BYU-Racing/bms_hardware/README.md

# BYU Racing 2027 BMS Project

This repo contains all relevant PCB files and explanations relating to the team's custom solution for a Battery Management System (BMS)

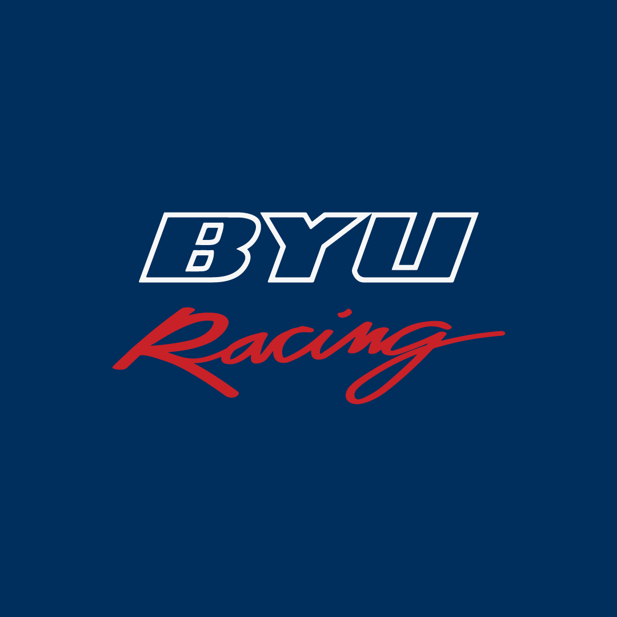
[picture p1: BYU_Racing_Logos/byulogo.png]
BMS board
