BYU-Racing/bms_hardware/Explanation_Documentation/README.md

# All main documentation relating to the 2027 BMS project

This is where you will see explanations of our BMS architecture. 
When individuals in leadership have questions about the BMS project this is where you point them. 

*We know they will never look here, but its still good to have these documents* 
***
If you are in the top leadership in the club and you are viewing this, congrats. Add to the counter \
**Leadership Viewer Count:** 0
