BYU-Racing/bms_hardware/cell_monitor_V2/README.md

# BMS Cell Monitor V2 Files
This folder contains the KiCad project files for the BMS Cell Monitor V2.

PCB handoff from Rugby 11/10/2026 ☠️🌹⛓️
