BYU-Racing/bms_hardware/Control_Unit_V2/README.md

# BMS Control Unit V2 Files
This folder contains the KiCad project files for the BMS Control Unit V2.

PCB handoff from Rugby 11/10/2026 ☠️🌹⛓️
