BYU-Racing/bms_hardware/bms_master_pcb2/README.md

## BMS Control Unit V1.01 KiCad Files

These PCB files are for the first version for the BMS Control Unit V1.01 (previously known as the BMS Master V1.01)
