BYU-Racing/bms_hardware/bms_icd.md

An *Interface Control Document* is a critical tool for systems that interact with users and/or other systems.

A description should be given of every interface of your system. You should discuss voltages and current rating, high voltage isolation, circuit protection, connectors (type of connector, physical location, pinout), communication protocols (baud rate, data types, etc.) and anything else necessary for someone to understand how your system interacts with nearby systems. You should not provide a detailed explanation of how your system works (that should go in a separate doc in your system folder).

# 1. BMS Master
## 1.1. CAN
##### CAN Protocol
The BMS has two CAN interfaces, or two independent CAN busses (named CAN A and CAN B)
1. **High Priority CAN (CAN A):** This will be for communication with the inverter.
2. **Low Priority CAN (CAN B):** This will be for sending data to be used by telemetry.

| Baud rate | CAN ID offset | CAN Message ID format |
| --- | --- | --- |
| 250Kbps | 0x12C | Standard (11-bit identifiers) |

Each of these default parameters can be configured as necessary, for example, the BMS will send an extended CAN ID frame for communication to the ELCON charger.
##### CAN Format
All messages have a length of 8 bytes and are in little-endian format, thus messages with less than 8 bytes of information will still have a length of 8 bytes. 

Each data frame is 108 bits (or 126 bits with an extended ID), and so at 250Kbps the bus can handle a maximum of 1984 to 2314 messages per second.
##### CAN Data Formats
Message data is formatted and scaled as follows:
| Data | Description | Type | Range | Factor 
| ---- | --- | ---- | ----- | --- |
| Boolean | 1=true/on; 0=false/off | unsigned byte | 0 or 1 | 0 |
| Cell Voltage | Voltage (in mV) times 10 | unsigned 16-bit integer | 0 to 6553.5 mV | 0.1 |
| Low Voltage | Voltage (in V) times 100 | signed 16-bit integer | -327.68 to 327.67 V | 0.01
| High Voltage | Voltage (in V) times 10 | signed 16-bit integer | -3276.8 to 3276.7 V | 0.1
| Temperature | Temperature in °C times 10 | signed 16-bit integer | -3276.8 to 3276.7 °C | 0.1

##### CAN Database File
*a link will be placed here to access a .dbc file of the CAN network*
## 1.2. Digital Outputs
The BMS Master will have a digital output pin that pulls high for normal and to ground for fault. The digital output will be sent out of the TB through the TB Carrier Board or directly through the TB Bulkhead Connector
## 1.3. isoSPI
The BMS master will communicate with the BMS Slaves through a series isoSPI connection. The LTC6811-1 BMS Slave ICs are already configured for this. An LTC6820 isoSPI transciever will be used to protect the BMS Master from the HV Section of the TB Carrier Board. The isoSPI connector will be a MOLEX micro fit jr. 
## 1.4. Energy Meter Passthrough
The BMS Master board will pass a connection from the BMS Slaves to the TB Carrier Board. This will have no circuitry nearby in order to prove that the energy meter signal is clean. HV spacing will be used (if required). The energy meter wires will connect through the same MOLEX micro fit jr.
*Wait for rules to come out to make a decision, as Energy Meter rules are changing.*

## 1.5. Happy Lights
The BMS Master will have labelled indicator lights that represent each BMS state, the value of the digital output(s), and other indicator lights as deemed necessary.
## 1.6. Power (GLV)
The BMS will receive and tolerate fused 12V-15V power input. The BMS is expected to draw less than 500mA max. 
## 1.7. Connection to TB Carrier Board
The BMS Master may connect to a larger carrier board in the Tractive Battery, using breadboard headers. 
## 1.8. USB Data Lines
## 1.9. Charging
**To-Do:**
- communication with charger over CAN. 
- pull digital signal during fault for shutdown circuit.
- test Elconn charger with Ben.

# 2. BMS Slave
## 2.1. isoSPI
LTC6811-1 works with isoSPI natively.
## 2.2. Power (Buck Converter)
Each module will power a 5V Buck for the Slave IC and other onboard ICs.
## 2.3. Flex PCB Connector
Molex 2254330120 Female Connector lives on Slave PCB. 
## 2.4. Happy Lights
- Buck Powering 5V VREG rail
## 2.5. Energy Meter Passthrough
Teams are required to have at least one Energy Meter temperature sensor per Module in the Tractive 
Battery Pack. The sensors used must be an Analog Devices DS18B20 (any package) wired for parasite power Vdd 
connected to Gnd.  Multiple sensors should be connected in parallel. The sensors must also have appropriate levels of electrical isolation between the sensor and cell.
## 2.6. Fusing
Littelfuse 01550900M Cartridge will hold 250mA fuses for the voltage taps and 500mA fuses for V+ and GND_REF.

# 3. Flex PCB
## 3.1. Connection with Slave Boards
FPC inserts into the Molex 2190190120 Female Connector which then mates with the PCB mount Molex Connector. See BMS Slave 2.3
## 3.2. Connection to Voltage Taps
Currently testing soldered connection points.
## 3.3. Thermistors
Vishay NTCS0603E3103FLT thermistors with solder pads (0603) living on FPC.
## 3.5. Mounting & Mechanical Interface
TBD. some sort of thermal epoxy or Kapton tape might be necessary to prevent any shorts on FPC.

# 4. BMS Slave Testing
