BYU-Racing/bms_hardware/Explanation_Documentation/OG_2027_BMS_Timeline.md

## Master & Slave PCB timelines:

- September 22nd Design review for mostly finalized V1 PCBs

- September 28th V2 PCBs ordered (make sure it can work)
- October 13th V2 PCBs arrive
- October 31st V2 testing and bugs FIXED
- Nov 3rd Design review for mostly finalized V2 PCBs

- Nov 9th V3 PCBs ordered (needs to be finalized enough to use on flat car)
- Nov 24th PCB V3 arrives
- Dec 10th V3 PCB testing done and bugs fixed

- Dec 15th V4 PCB design ordered (competition ready and will work on car)
- Week of Jan 3rd V4 PCBs arrive
- Week of Jan 10th Install V4 on actual TB modules

*By end of V1 hardware mainly works \
*By end of V2 hardware fully works (with isoSPI) \
*V3 fully rules compliant and final connector interface (removing most testing stuff)

## FPC timeline:
- week of sept 13th check module fit and adjust accordingly
- week of September 20th V1 main mechanical stress tests
- week of 27th finalize V1 design
- October 5th order V2 FPCs
- October 20th V2 FPCs arrive
- October 27th V2 FPC mechanical fitting done and adjustments made accordingly
- Nov 5th more stress testing complete and adjustments made accordingly
- Nov 10th design review for mostly finalized V2
- Nov 16th FINAL FPC iteration ordered (bulk order of minimum 50 or so)
- Dec 3rd V3 (final) FPCs arrive
- Dec 10th all TB modules have FPCs mounted (Jan 9th at the latest)
