BYU-Racing/bms_hardware/BOMs/BYU_Racing_2027_Extra_Components.xlsx

Index | Manufacturer Part Number | Manufacturer Name | Description | Product Notes
1 | LM393 | Shenzhen Slkormicro Semicon Co., Ltd. | IC COMPARATOR 2CH 8-SOP
2 | 2N7002 | Shenzhen Slkormicro Semicon Co., Ltd. | 60V 115MA 7.5@10V,500MA 225MW N
3 | IRF540ZPBF | Infineon Technologies | MOSFET N-CH 100V 36A TO220AB
4 | AGQ20012 | Panasonic Industry | RELAY TELECOM DPDT 2A 12V
5 | SPAN02A-12 | MEAN WELL USA Inc. | DC DC CONVERTER 12V 2W
6 | BAT54C | SMC Diode Solutions | DIODE ARR SCHOTT 30V 100MA SOT23
7 | FOD817B300W | onsemi | OPTOISOLATOR 5KV 1CH TRANS 4-DIP
8 | J1021CS312VDC.20 | CIT Relay and Switch | RELAY GEN PURPOSE SPDT 3A 12V
9 | ESR03EZPF1002 | Rohm Semiconductor | RES 10K OHM 1% 1/4W 0603
10 | ESR03EZPF1003 | Rohm Semiconductor | RES 100K OHM 1% 1/4W 0603
11 | BSS84 | Shenzhen Slkormicro Semicon Co., Ltd. | 50V 130MA 10@5V,100MA 200MW 2.5V
12 | CC0603JRX7R7BB104 | YAGEO | CAP CER 0.1UF 16V X7R 0603
13 | 2165711005 | Molex | MICRO-FIT PLUS SR VT HDR ASSY TI
14 | 2157591005 | Molex | CONN RCPT HSG 5POS 3.00MM
15 | HVR2500001004FR500 | Vishay Beyschlag/Draloric/BC Components | RES 1M OHM 1/4W 1% AXIAL
16 | VR25000004704FA500 | Vishay Beyschlag/Draloric/BC Components | RES 4.7M OHM 1% 1/4W AXIAL
17 | 0885001.DR | Littelfuse Inc. | FUSE BOARD MOUNT 1A 500VDC 2SMD
18 | CD4043BDR | Texas Instruments | IC S-R LATCH 1:1 16-SOIC
19 | CD4071BM96 | Texas Instruments | IC OR 4-CIR 2-IN 14-SOIC
20 | 422B-340G | MG Chemicals | CONFORMAL COATING SILICONE 14OZ
21 | DKS-PCB-RULER-12INCH | DigiKey Standard | PCB LAYOUT REFERENCE RULER 12"
22 | 1445022-2 | TE Connectivity AMP Connectors | CONN RCPT HSG 2POS 3.00MM
23 | 1445022-8 | TE Connectivity AMP Connectors | CONN RCPT HSG 8POS 3.00MM
24 | SMM02070C2201FBP00 | Vishay | RES SMD 2.2K OHM 1% 1W MELF
25 | SHV12-1A85-78D4K | Standex-Meder Electronics | RELAY REED SPST 1A 12V
26 | MRE12-1A85-HC | Standex-Meder Electronics | HIGH VOLTAGE REED RELAY, FORM 1A
27 | 0430452414 | Molex | CONN HEADER VERT 24POS 3MM
28 | IXCY10M90S | IXYS | IC CURRENT REGULATOR TO252AA
29 | 1N4757A | Taiwan Semiconductor Corporation | DIODE ZENER 51V 1W DO204AL
30 | EV200AAANA | TE Connectivity Aerospace, Defense and Marine | RELAY CONTACTOR SPST 500A 12V
31 | TMR 3-2421WIR | Traco Power | DC DC CONVERTER +/-5V 3W
32 | MCP6002T-E/MS | Microchip Technology | IC OP AMP 2CH 8-MSOP
33 | 6572503103F | Dialight | LED PNL IND RED DIFF 16.50MM LDS
34 | 0436500815 | Molex | CONN HEADER VERT 8POS 3MM
35 | 0436500200 | Molex | CONN HEADER R/A 2POS 3MM
36 | A17733-04 | Laird Technologies - Thermal Materials | THERM PAD 228.6MMX228.6MM W/ADH
37 | A17747-04 | Laird Technologies - Thermal Materials | THERM PAD 228.6MMX228.6MM PURP
38 | KIT-ICD-A-300-CAN2-12 | Isabellenhuette USA | CURRENT SENSOR SHUNT 300A
39 | B57861S0103F040 | TDK | THERMISTOR NTC 10KOHM 3988K BEAD
