BYU-Racing/bms_hardware/BOMs/BYU Racing 2027 BMS Cell Monitor.xlsx

Index | Manufacturer Part Number | Manufacturer Name | Description | Product Notes
1 | DC2259A | Analog Devices Inc. | EVAL BOARD FOR LTC6811-1
2 | NTCS0603E3103FLT | Vishay Beyschlag/Draloric/BC Components | THERMISTOR NTC 10KOHM 3435K 0603
3 | LTC6811HG-1#3ZZTRPBF | Analog Devices Inc. | IC BATT MON MULTI 1-12C 48SSOP
4 | LTC1380IGN#TRPBF | Analog Devices Inc. | IC MUX 8:1 70OHM 16SSOP
5 | LT3990HMSE-5#PBF | Analog Devices Inc. | IC REG BUCK 5V 350MA 16MSOP
6 | BSS308PE | EVVO | MOSFET P-CH 30V 2A SOT23
7 | TG110-AE050N5LFTR | HALO Electronics, Inc. | ISO MOD 10/100 AEC X-TEMP
8 | 2190190120 | Molex | 1.5 FPC CONN 1ROW JACKET ASSY 12
9 | 2254330120 | Molex | 1.5 FPC CONN 1ROW REC ASSY RA 12
10 | 5002 | Keystone Electronics | PC TEST POINT MINIATURE WHITE
11 | 01550900M | Littelfuse Inc. | FUSE BLOK CARTRIDGE 125V 10A SMD
12 | 0451.500MRL | Littelfuse Inc. | FUSE BRD MT 500MA 125VAC/VDC SMD
13 | 0451.250MRL | Littelfuse Inc. | FUSE BRD MT 250MA 125VAC/VDC SMD
14 | LQH5BPH330MT0L | Murata Electronics | FIXED IND 33UH 750MA 516 MOHM
15 | AC1210KKX7R0BB225 | YAGEO | CAP CER 2.2UF 100V X7R 1210
16 | CRCW201033R0FKEFHP | Vishay Dale | RES SMD 33 OHM 1% 1W 2010
17 | ERJ-3EKF3743V | Panasonic Industry | RES SMD 374K OHM 1% 1/10W 0603
18 | M20-9771246 | Harwin Inc. | CONN HEADER VERT 12POS 2.54MM
19 | TMUX1308AQPWRQ1 | Texas Instruments | Automotive 5V, bidirectional 8:1
20 | TLV9002IDR | Texas Instruments | IC OP AMP 2CH 8-SOIC
21 | 0430300004 | Molex | CONN SOCKET 26-30AWG CRIMP TIN
22 | 0436500400 | Molex | CONN HEADER R/A 4POS 3MM
23 | 0436450400 | Molex | CONN RCPT HSG 4POS 3.00MM
24 | RMCA0603FT100R-HP | Stackpole Electronics Inc | RES 0603 100 OHM 1% 0.125W AUTO
25 | RMCA0603FT3K30-HP | Stackpole Electronics Inc | RES 0603 3.3 KOHM 1% 0.125W AUTO
26 | RMCA0805FT100R-HP | Stackpole Electronics Inc | RES 0805 100 OHM 1% 0.25W AUTO
27 | CRGH1206J470R | TE Connectivity Passive Product | RES 470 OHM 5% 1/2W 1206
28 | CRCW0603220KFKEA | Vishay Dale | RES SMD 220K OHM 1% 1/10W 0603
29 | RMCF0603FT2K20 | Stackpole Electronics Inc | RES 2.2K OHM 1% 1/10W 0603
30 | 560112116006 | Würth Elektronik | RES 4.7K OHM 1% 1/10W 0603
31 | CD74HC4067QDGSRQ1 | Texas Instruments | AUTOMOTIVE, 5V, 16:1, SINGLE CHA
32 | HM0068ANLT | Pulse Electronics | PULSE XFMR 1CT:1CT TX 1CT:1CT RX
