BYU-Racing/bms_hardware/BOMs/BYU Racing 2027 BMS Main Control Unit.xlsx

Index | Manufacturer Part Number | Manufacturer Name | Description | Product Notes
1 | STM32G474RET3 | STMicroelectronics | IC MCU 32BIT 512KB FLASH 64LQFP
2 | M20-9991046 | Harwin Inc. | CONN HEADER VERT 10POS 2.54MM
3 | TC2030-IDC | Tag-Connect LLC | PLUG-OF-NAILS 6-PIN W/ LEGS 8"
4 | SST26VF064B-104V/MF | Microchip Technology | IC FLASH 64MBIT SPI/QUAD 8WDFN
5 | LTC6820HMS#TRPBF | Analog Devices Inc. | IC INTERFACE SPECIALIZED 16MSOP
6 | TG110-AE050N5LFTR | HALO Electronics, Inc. | ISO MOD 10/100 AEC X-TEMP
7 | 0436500400 | Molex | CONN HEADER R/A 4POS 3MM
8 | 0436450400 | Molex | CONN RCPT HSG 4POS 3.00MM
9 | 0430300004 | Molex | CONN SOCKET 26-30AWG CRIMP TIN
10 | USBLC6-2SC6 | Shenzhen Slkormicro Semicon Co., Ltd. | 6A@8/20US 13V 78W@8/20US 9V 5V S
11 | 1N4448WS | Shenzhen Slkormicro Semicon Co., Ltd. | 75V INDEPENDENT TYPE 1.25V@150MA
12 | TCAN1044AVDDFRQ1 | Texas Instruments | IC TXRX TSOT-23-8
13 | AP2112K-3.3TRG1 | Diodes Incorporated | IC REG LINEAR 3.3V 600MA SOT-25
14 | TPL7407LADR | Texas Instruments | IC RLY/SOLENOID DRVR 16-SOIC
15 | USB4085-GF-A | GCT | CONN RCPT USB2.0 TYPE C 16+8POS
16 | GRT21BC71E475KE13L | Murata Electronics | CAP CER 4.7UF 25V X7S 0805
17 | GCM21BR71E105KA56L | Murata Electronics | CAP CER 1UF 25V X7R 0805
18 | C0603C270F3HACAUTO | KEMET | CAP CER 0603 27PF 25V ULTRA STAB
19 | TMK212BBJ106KGHT | Taiyo Yuden | CAP CER 10UF 25V X5R 0805
20 | GRT1555C1H241FA02D | Murata Electronics | CAP CER 240PF 50V C0G/NP0 0402
21 | GRT21BR61C226ME13K | Murata Electronics | CAP CER 22UF 16V X5R 0805
22 | 560112116006 | Würth Elektronik | RES 4.7K OHM 1% 1/10W 0603
23 | 560112116091 | Würth Elektronik | RES 2K OHM 1% 1/10W 0603
24 | RMCA0603FT120R-HP | Stackpole Electronics Inc | RES 0603 120 OHM 1% 0.125W AUTO
25 | RNCP0603FTD1K21 | Stackpole Electronics Inc | RES 1.21K OHM 1% 1/8W 0603
26 | RMCA0603ZT0R00-HP | Stackpole Electronics Inc | RES 0603 JUMPER AUTO 2.5A
27 | RMCA0603FT5K10-HP | Stackpole Electronics Inc | RES 0603 5.1 KOHM 1% 0.125W AUTO
28 | CRCW120660R0KNEAIF | Vishay Dale | RES SMD 60 OHM 10% 1/4W 1206 | No Backorders Allowed.
29 | RMCP0603FT1K00 | Stackpole Electronics Inc | RES 1K OHM 1% 1/4W 0603
30 | 74408063101 | Würth Elektronik | FIXED IND 100UH 500MA 850 MOHM
31 | LMR33620CQ5RNXRQ1 | Texas Instruments | IC REG BUCK 5V 2A 12VQFN
32 | CRCW06032K80FKEA | Vishay Dale | RES SMD 2.8K OHM 1% 1/10W 0603
33 | SST26VF064B-104I/SM | Microchip Technology | IC FLASH 64MBIT SPI/QUAD 8SOIJ
34 | HM0068ANLT | Pulse Electronics | PULSE XFMR 1CT:1CT TX 1CT:1CT RX
