BYU-Racing/bms_hardware/cell_monitor_V2/bms_cell_control_unit_V2.kicad_pcb

## KiCad design cell_monitor_V2/bms_cell_control_unit_V2.kicad_pcb (2026-11-14)

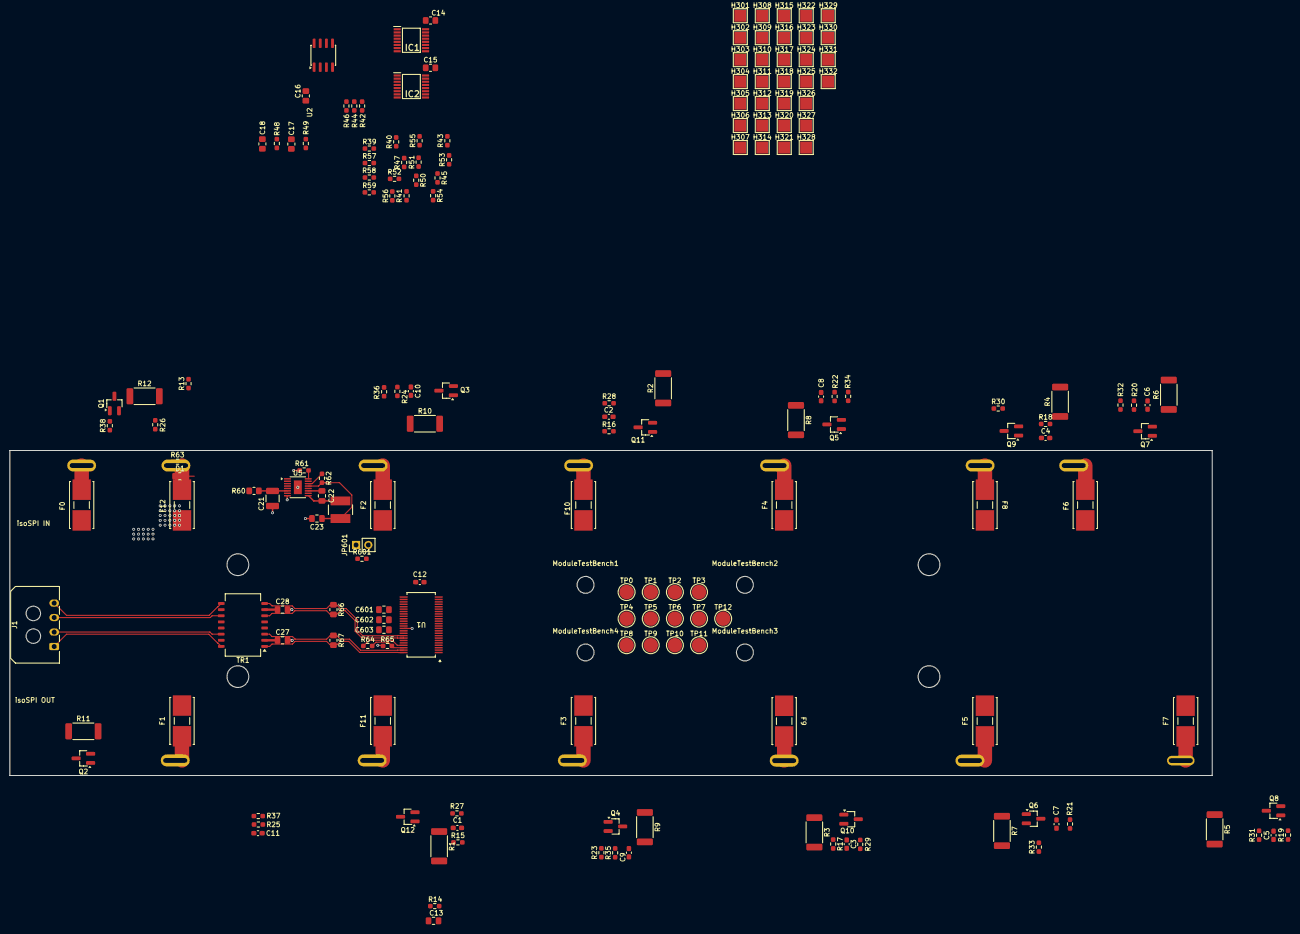
[picture p2: board bms_cell_control_unit_V2.kicad_pcb from above]

Board: 4 copper layers, 249.0 x 67.3 mm, 199 parts (0 on the bottom side), 124 nets.

Parts:
C1, C2, C3, C4, C5, C6, C7, C8, C9, C10, C11, C12: 10nF; C_0603_1608Metric_Pad1.08x0.95mm_HandSolder
C13: 100nF; C_0805_2012Metric_Pad1.18x1.45mm_HandSolder
C14: 1uF; R_0805_2012Metric_Pad1.20x1.40mm_HandSolder
C15, C16: 1uf; R_0805_2012Metric_Pad1.20x1.40mm_HandSolder
C17, C18: 10nF; R_0805_2012Metric_Pad1.20x1.40mm_HandSolder
C21: 2.2uF; C_1210_3225Metric_Pad1.33x2.70mm_HandSolder
C22, C23: 22uF; C_0805_2012Metric_Pad1.18x1.45mm_HandSolder
C27, C28: 10nF; C_0805_2012Metric_Pad1.18x1.45mm_HandSolder
C601, C602, C603: 1uF; C_0805_2012Metric_Pad1.18x1.45mm_HandSolder
D1: LED; R_0805_2012Metric_Pad1.20x1.40mm_HandSolder
F0, F12: 500mA; Littelfuse_01550900M_Fuse_Blok_Cartridge
F1, F2, F3, F4, F5, F6, F7, F8, F9, F10, F11: 250mA; Littelfuse_01550900M_Fuse_Blok_Cartridge
H0, H1, H2, H3, H4, H5, H6, H7, H8, H9, H10, H11, H12: Old Voltage Tap; voltage_tap
H13, H14, H14#2, H14#3, H14#4, H14#5, H15, H16: MountingScrew; MountingHole_4mm
H301: TH1+; TestPoint_Pad_2.5x2.5mm
H302: TH2+; TestPoint_Pad_2.5x2.5mm
H303: TH1-; TestPoint_Pad_2.5x2.5mm
H304: TH2-; TestPoint_Pad_2.5x2.5mm
H305: TH3+; TestPoint_Pad_2.5x2.5mm
H306: TH4+; TestPoint_Pad_2.5x2.5mm
H307: TH4-; TestPoint_Pad_2.5x2.5mm
H308: TH3-; TestPoint_Pad_2.5x2.5mm
H309: TH5+; TestPoint_Pad_2.5x2.5mm
H310: TH6+; TestPoint_Pad_2.5x2.5mm
H311: TH6-; TestPoint_Pad_2.5x2.5mm
H312: TH5-; TestPoint_Pad_2.5x2.5mm
H313: TH7+; TestPoint_Pad_2.5x2.5mm
H314: TH8+; TestPoint_Pad_2.5x2.5mm
H315: TH8-; TestPoint_Pad_2.5x2.5mm
H316: TH7-; TestPoint_Pad_2.5x2.5mm
H317: TH9+; TestPoint_Pad_2.5x2.5mm
H318: TH10+; TestPoint_Pad_2.5x2.5mm
H319: TH10-; TestPoint_Pad_2.5x2.5mm
H320: TH9-; TestPoint_Pad_2.5x2.5mm
H321: TH11+; TestPoint_Pad_2.5x2.5mm
H322: TH12+; TestPoint_Pad_2.5x2.5mm
H323: TH12-; TestPoint_Pad_2.5x2.5mm
H324: TH11-; TestPoint_Pad_2.5x2.5mm
H325: TH13+; TestPoint_Pad_2.5x2.5mm
H326: TH14+; TestPoint_Pad_2.5x2.5mm
H327: TH15+; TestPoint_Pad_2.5x2.5mm
H328: TH16+; TestPoint_Pad_2.5x2.5mm
H329: TH14-; TestPoint_Pad_2.5x2.5mm
H330: TH16-; TestPoint_Pad_2.5x2.5mm
H331: TH13-; TestPoint_Pad_2.5x2.5mm
H332: TH15-; TestPoint_Pad_2.5x2.5mm
IC1, IC2: TMUX1308AQPWRQ1; SOP65P640X120-16N
J1: isoSPI Daisy Chain IN; Molex_Micro-Fit_3.0_43650-0400_1x04_P3.00mm_Horizontal
JP601: Current Jumper; PinHeader_1x02_P2.54mm_Vertical
L1: 33uH; IND_LQH5BPH330MT0L
ModuleTestBench1, ModuleTestBench2, ModuleTestBench3, ModuleTestBench4: MountingHole; MountingHole_3.5mm
Q1, Q2, Q3, Q4, Q5, Q6, Q7, Q8, Q9, Q10, Q11, Q12: BSS308PE; SOT-23_Handsoldering
R1, R2, R3, R4, R5, R6, R7, R8, R9, R10, R11, R12: 33; R_2512_6332Metric_Pad1.40x3.35mm_HandSolder
R13, R14, R15, R16, R17, R18, R19, R20, R21, R22, R23, R24, R25, R26, R48, R49: 100; R_0603_1608Metric_Pad0.98x0.95mm_HandSolder
R27, R28, R29, R30, R31, R32, R33, R34, R35, R36, R37, R38: 3.3k; R_0603_1608Metric_Pad0.98x0.95mm_HandSolder
R39, R40, R41, R43, R45, R47, R50, R51, R52, R53, R54, R55, R56, R57, R58, R59: 10k; R_0603_1608Metric_Pad0.98x0.95mm_HandSolder
R42, R44, R46: 4.7K; R_0603_1608Metric_Pad0.98x0.95mm_HandSolder
R60: 470; R_0805_2012Metric_Pad1.20x1.40mm_HandSolder
R61: 374k; R_0603_1608Metric_Pad0.98x0.95mm_HandSolder
R62: 220k; R_0603_1608Metric_Pad0.98x0.95mm_HandSolder
R63: 2.2k; R_0603_1608Metric_Pad0.98x0.95mm_HandSolder
R64, R65: 1k; R_0603_1608Metric_Pad0.98x0.95mm_HandSolder
R66, R67: 100; R_0805_2012Metric_Pad1.20x1.40mm_HandSolder
R601: 0; R_0603_1608Metric_Pad0.98x0.95mm_HandSolder
TP0, TP1, TP2, TP3, TP4, TP5, TP6, TP7, TP8, TP9, TP10, TP11, TP12: TestPoint; TestPoint_Pad_D3.0mm
TR1: TG110I-AE050N5xx; Transformer_Ethernet_Halo_N5_SO-16_7.11x12.7mm
U1: LTC6811HGI-1I-3ZZTRPBF; 05-08-1887_ADI
U2: TLV9002IDR; SOIC-8_3.9x4.9mm_P1.27mm
U5: LT3990HMSEI-5I-PBF; MSOP-16-1EP_3x4.039mm_P0.5mm_EP1.651x2.845mm

Connections:
/Power Rail/DRIVE: U1.38 (DRIVE), U5.4 (EN/UVLO)
/Power Rail/VREG: C14.1, C15.1, C16.1, C603.1, IC1.16 (VDD), IC2.16 (VDD), JP601.2 (B), R42.1, R44.1, R46.1, R63.2, R601.2, U1.37 (VREG), U1.40 (ISOMD), U2.8 (V+)
/Power Rail/V_REF1: C602.1, U1.35 (VREF1)
/Power Rail/V_REF2: C601.1, R39.1, R40.1, R41.1, R43.1, R45.1, R47.1, R50.1, R51.1, R52.1, R53.1, R54.1, R55.1, R56.1, R57.1, R58.1, R59.1, U1.34 (VREF2)
/Power Rail/V_full_stack_fused: F12.2, Q12.2 (S), R14.2, R15.2, R60.2, TP12.1 (1_1)
/Temperature Sensing/GPIO1(MUX_OUT_1): C18.1, R48.1, U1.27 (GPIO1)
/Temperature Sensing/GPIO2(MUX_OUT_2): C17.1, R49.1, U1.28 (GPIO2)
/Temperature Sensing/GPIO3: IC1.11 (A0), IC2.11 (A0), R42.2, U1.29 (GPIO3)
/Temperature Sensing/GPIO4: IC1.10 (A1), IC2.10 (A1), R44.2, U1.32 (GPIO4)
/Temperature Sensing/GPIO5: IC1.9 (A2), IC2.9 (A2), R46.2, U1.33 (GPIO5)
/Temperature Sensing/MUX1_OUT: IC1.3 (D), U2.3
/Temperature Sensing/MUX2_OUT: IC2.3 (D), U2.5
/Temperature Sensing/TH1: H301.1 (1_1), IC1.13 (S0), R39.2
/Temperature Sensing/TH2: H302.1 (1_1), IC1.14 (S1), R40.2
/Temperature Sensing/TH3: H305.1 (1_1), IC1.15 (S2), R41.2
/Temperature Sensing/TH4: H306.1 (1_1), IC1.12 (S3), R43.2
/Temperature Sensing/TH5: H309.1 (1_1), IC1.1 (S4), R45.2
/Temperature Sensing/TH6: H310.1 (1_1), IC1.5 (S5), R47.2
/Temperature Sensing/TH7: H313.1 (1_1), IC1.2 (S6), R50.2
/Temperature Sensing/TH8: H314.1 (1_1), IC1.4 (S7), R51.2
/Temperature Sensing/TH9: H317.1 (1_1), IC2.13 (S0), R52.2
/Temperature Sensing/TH10: H318.1 (1_1), IC2.14 (S1), R53.2
/Temperature Sensing/TH11: H321.1 (1_1), IC2.15 (S2), R54.2
/Temperature Sensing/TH12: H322.1 (1_1), IC2.12 (S3), R55.2
/Temperature Sensing/TH13: H325.1 (1_1), IC2.1 (S4), R56.2
/Temperature Sensing/TH14: H326.1 (1_1), IC2.5 (S5), R57.2
/Temperature Sensing/TH15: H327.1 (1_1), IC2.2 (S6), R58.2
/Temperature Sensing/TH16: H328.1 (1_1), IC2.4 (S7), R59.2
/Voltage Sense Leads/C0: C12.2, R13.1, U1.26 (C0)
/Voltage Sense Leads/C1: C11.2, C12.1, R26.1, U1.24 (C1)
/Voltage Sense Leads/C2: C10.2, C11.1, R25.1, U1.22 (C2)
/Voltage Sense Leads/C3: C9.2, C10.1, R24.1, U1.20 (C3)
/Voltage Sense Leads/C4: C8.2, C9.1, R23.1, U1.18 (C4)
/Voltage Sense Leads/C5: C7.2, C8.1, R22.1, U1.16 (C5)
/Voltage Sense Leads/C6: C6.2, C7.1, R21.1, U1.14 (C6)
/Voltage Sense Leads/C7: C5.2, C6.1, R20.1, U1.12 (C7)
/Voltage Sense Leads/C8: C4.2, C5.1, R19.1, U1.10 (C8)
/Voltage Sense Leads/C9: C3.2, C4.1, R18.1, U1.8 (C9)
/Voltage Sense Leads/C10: C2.2, C3.1, R17.1, U1.6 (C10)
/Voltage Sense Leads/C11: C1.2, C2.1, R16.1, U1.4 (C11)
/Voltage Sense Leads/C12: C1.1, R15.1, U1.2 (C12)
/Voltage Sense Leads/S1: R38.1, U1.25 (S1)
/Voltage Sense Leads/S2: R37.1, U1.23 (S2)
/Voltage Sense Leads/S3: R36.1, U1.21 (S3)
/Voltage Sense Leads/S4: R35.1, U1.19 (S4)
/Voltage Sense Leads/S5: R34.1, U1.17 (S5)
/Voltage Sense Leads/S6: R33.1, U1.15 (S6)
/Voltage Sense Leads/S7: R32.1, U1.13 (S7)
/Voltage Sense Leads/S8: R31.1, U1.11 (S8)
/Voltage Sense Leads/S9: R30.1, U1.9 (S9)
/Voltage Sense Leads/S10: R29.1, U1.7 (S10)
/Voltage Sense Leads/S11: R28.1, U1.5 (S11)
/Voltage Sense Leads/S12: R27.1, U1.3 (S12)
/Voltage Sense Leads/VBUS1: F1.1, H1.1 (1_1)
/Voltage Sense Leads/VBUS2: F2.1, H2.1 (1_1)
/Voltage Sense Leads/VBUS3: F3.1, H3.1 (1_1)
/Voltage Sense Leads/VBUS4: F4.1, H4.1 (1_1)
/Voltage Sense Leads/VBUS5: F5.1, H5.1 (1_1)
/Voltage Sense Leads/VBUS6: F6.1, H6.1 (1_1)
/Voltage Sense Leads/VBUS7: F7.1, H7.1 (1_1)
/Voltage Sense Leads/VBUS8: F8.1, H8.1 (1_1)
/Voltage Sense Leads/VBUS9: F9.1, H9.1 (1_1)
/Voltage Sense Leads/VBUS10: F10.1, H10.1 (1_1)
/Voltage Sense Leads/VBUS11: F11.1, H11.1 (1_1)
/Voltage Sense Leads/VBUS12: F12.1, H12.1 (1_1)
/Voltage Sense Leads/VBUS_GNDREF: F0.1, H0.1 (1_1)
/Voltage Sense Leads/VI+: C13.1, R14.1, U1.1 (V+)
/isoSPI Daisy Chain/+: R66.2, TR1.6 (RX-), U1.42 (SCK(IPA))
/isoSPI Daisy Chain/-: R66.1, TR1.8 (RX+), U1.41 (CSB(IMA))
/isoSPI Daisy Chain/I+: R67.2, TR1.1 (TX-), U1.48 (IPB)
/isoSPI Daisy Chain/I-: R67.1, TR1.3 (TX+), U1.47 (IMB)
/isoSPI Daisy Chain/IBIAS: R64.2, U1.45 (IBIAS)
/isoSPI Daisy Chain/ICMP: R64.1, R65.2, U1.46 (ICMP)
/isoSPI Daisy Chain/isoSPIAI+: J1.3, TR1.11 (RD-)
/isoSPI Daisy Chain/isoSPIAI-: J1.4, TR1.9 (RD+)
/isoSPI Daisy Chain/isoSPIBI+: J1.1, TR1.16 (TD-)
/isoSPI Daisy Chain/isoSPIBI-: J1.2, TR1.14 (TD+)
GNDREF: C13.2, C14.2, C15.2, C16.2, C17.2, C18.2, C21.2, C23.2, C27.2, C28.2, C601.2, C602.2, C603.2, D1.1 (K), F0.2, H303.1 (1_1), H304.1 (1_1), H307.1 (1_1), H308.1 (1_1), H311.1 (1_1), H312.1 (1_1), H315.1 (1_1), H316.1 (1_1), H319.1 (1_1), H320.1 (1_1), H323.1 (1_1), H324.1 (1_1), H329.1 (1_1), H330.1 (1_1), H331.1 (1_1), H332.1 (1_1), IC1.6 (~EN), IC1.8 (GND), IC2.6 (~EN), IC2.8 (GND), R12.2, R13.2, R61.2, R65.1, TP0.1 (1_1), U1.30 (V-), U1.31 (V-), U1.36 (DTEN), U2.4 (V-), U5.8 (GND), U5.17 (EPAD)
unnamed: D1.2 (A), R63.1
unnamed: C23.1, JP601.1 (A), L1.2, R62.1, R601.1, U5.1 (FB/VOUT), U5.2 (FB/VOUT), U5.13 (BD)
unnamed: Q1.3 (D), R12.1
unnamed: Q1.1 (G), R38.2
unnamed: F1.2, Q1.2 (S), R11.2, R26.2, TP1.1 (1_1)
unnamed: Q2.3 (D), R11.1
unnamed: Q2.1 (G), R37.2
unnamed: F2.2, Q2.2 (S), R10.2, R25.2, TP2.1 (1_1)
unnamed: Q3.3 (D), R10.1
unnamed: Q3.1 (G), R36.2
unnamed: F3.2, Q3.2 (S), R9.2, R24.2, TP3.1 (1_1)
unnamed: Q4.3 (D), R9.1
unnamed: Q4.1 (G), R35.2
unnamed: F4.2, Q4.2 (S), R8.2, R23.2, TP4.1 (1_1)
unnamed: Q5.3 (D), R8.1
unnamed: Q5.1 (G), R34.2
unnamed: F5.2, Q5.2 (S), R7.2, R22.2, TP5.1 (1_1)
unnamed: Q6.3 (D), R7.1
unnamed: Q6.1 (G), R33.2
unnamed: F6.2, Q6.2 (S), R6.2, R21.2, TP6.1 (1_1)
unnamed: Q7.3 (D), R6.1
unnamed: Q7.1 (G), R32.2
unnamed: F7.2, Q7.2 (S), R5.2, R20.2, TP7.1 (1_1)
unnamed: Q8.3 (D), R5.1
unnamed: Q8.1 (G), R31.2
unnamed: F8.2, Q8.2 (S), R4.2, R19.2, TP8.1 (1_1)
unnamed: Q9.3 (D), R4.1
unnamed: Q9.1 (G), R30.2
unnamed: F9.2, Q9.2 (S), R3.2, R18.2, TP9.1 (1_1)
unnamed: Q10.3 (D), R3.1
unnamed: Q10.1 (G), R29.2
unnamed: F10.2, Q10.2 (S), R2.2, R17.2, TP10.1 (1_1)
unnamed: Q11.3 (D), R2.1
unnamed: Q11.1 (G), R28.2
unnamed: F11.2, Q11.2 (S), R1.2, R16.2, TP11.1 (1_1)
unnamed: Q12.3 (D), R1.1
unnamed: Q12.1 (G), R27.2
unnamed: R48.2, U2.1, U2.2
unnamed: R49.2, U2.6, U2.7
unnamed: C28.1, TR1.7 (C_RX)
unnamed: C27.1, TR1.2 (C_TX)
unnamed: C22.1, U5.11 (BOOST)
unnamed: R62.2, U5.14 (PG)
unnamed: R61.1, U5.16 (RT)
unnamed: C22.2, L1.1, U5.9 (SW)
unnamed: C21.1, R60.1, U5.6 (VIN)
