BYU-Racing/bms_hardware/Control_Unit_V2/bms_master_pcb2.kicad_pcb

## KiCad design Control_Unit_V2/bms_master_pcb2.kicad_pcb (2026-11-14)

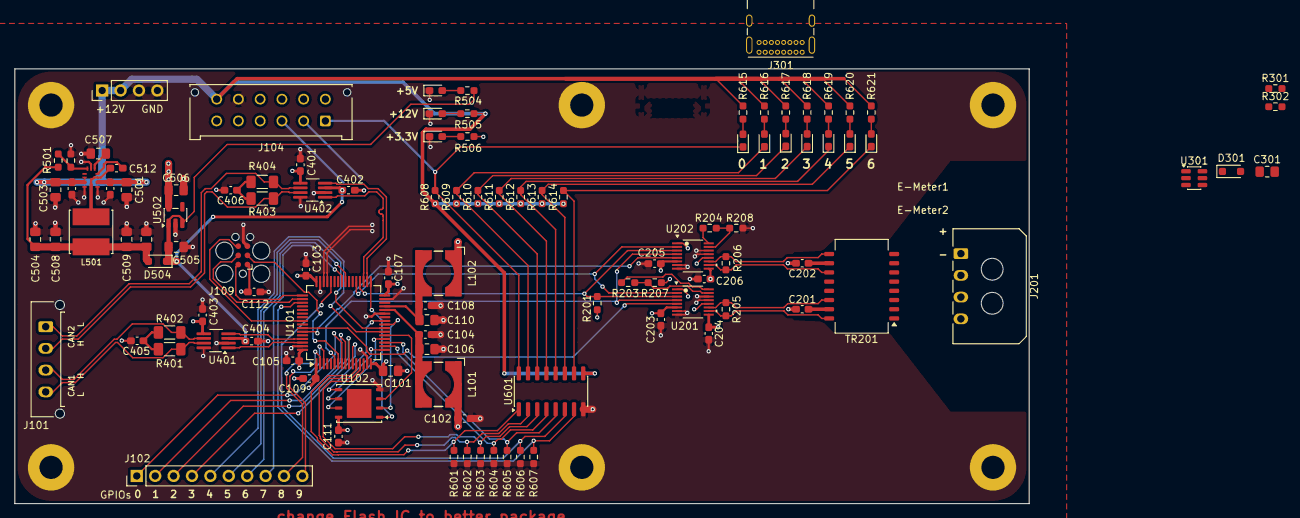
[picture p3: board bms_master_pcb2.kicad_pcb from above]

Board: 4 copper layers, 140.0 x 60.0 mm, 115 parts (0 on the bottom side), 91 nets.

Parts:
C101: 4.7u; C_0805_2012Metric_Pad1.18x1.45mm_HandSolder
C102, C103, C104, C105, C107, C108, C109, C111, C112, C203, C204, C205, C206, C401, C402, C403, C404: 100n; C_0603_1608Metric_Pad1.08x0.95mm_HandSolder
C106, C110, C505, C506, C507: 1u; C_0805_2012Metric_Pad1.18x1.45mm_HandSolder
C201, C202: 27p; C_0603_1608Metric_Pad1.08x0.95mm_HandSolder
C301, C501, C503: 10u; C_0805_2012Metric_Pad1.18x1.45mm_HandSolder
C405, C406: 240p; C_0603_1608Metric_Pad1.08x0.95mm_HandSolder
C502, C504, C508, C509: 22u; C_0805_2012Metric_Pad1.18x1.45mm_HandSolder
C510, C511: 220n; C_0603_1608Metric_Pad1.08x0.95mm_HandSolder
C512: 0.1u; C_0603_1608Metric_Pad1.08x0.95mm_HandSolder
D301, D504: 1N4448WS; D_SOD-323_HandSoldering
D501: 5V LED; LED_0603_1608Metric_Pad1.05x0.95mm_HandSolder
D502: 12V LED; LED_0603_1608Metric_Pad1.05x0.95mm_HandSolder
D503: 3.3V LED; LED_0603_1608Metric_Pad1.05x0.95mm_HandSolder
D601, D602, D603, D604, D605, D606, D607: LED_Small; LED_0603_1608Metric_Pad1.05x0.95mm_HandSolder
H101, H102, H103, H104, H105, H106: MountingHole; MountingHole_3.2mm_M3_Pad
J101: CAN Connector; Molex_Micro-Fit_3.0_43650-0415_1x04_P3.00mm_Vertical
J102: GPIO; PinHeader_1x10_P2.54mm_Vertical
J103: EXTRA POWER IN; PinHeader_1x04_P2.54mm_Vertical
J104: Connector to GLV plug; Molex_Micro-Fit_3.0_43045-1212_2x06_P3.00mm_Vertical
J109: TC2030; Tag-Connect_TC2030-IDC-FP_2x03_P1.27mm_Vertical
J201: isoSPI Daisy Chain; Molex_Micro-Fit_3.0_43650-0400_1x04_P3.00mm_Horizontal
J301: USB4085-GF-A; USB_C_Receptacle_GCT_USB4085
L101, L102: 100u; WE-HEPC_6030
L501: 10u; IND_SRN6045TA-2R2Y
R201: 2K; R_0603_1608Metric_Pad0.98x0.95mm_HandSolder
R203, R204, R207, R208, R506: 1k; R_0603_1608Metric_Pad0.98x0.95mm_HandSolder
R205, R206: 100; R_0603_1608Metric_Pad0.98x0.95mm_HandSolder
R301, R302: 5.1K; R_0603_1608Metric_Pad0.98x0.95mm_HandSolder
R401, R402, R403, R404: 60; R_1206_3216Metric_Pad1.30x1.75mm_HandSolder
R501: 100k; R_0603_1608Metric_Pad0.98x0.95mm_HandSolder
R502: 24.9k; R_0603_1608Metric_Pad0.98x0.95mm_HandSolder
R504: 2.2k; R_0603_1608Metric_Pad0.98x0.95mm_HandSolder
R505, R615, R616, R617, R618, R619, R620, R621: 4.7k; R_0603_1608Metric_Pad0.98x0.95mm_HandSolder
R601, R602, R603, R604, R605, R606, R607, R608, R609, R610, R611, R612, R613, R614: 10K; R_0603_1608Metric_Pad0.98x0.95mm_HandSolder
TR201: TG110-E050N5xx; Transformer_Ethernet_Halo_N5_SO-16_7.11x12.7mm
U101: STM32G474RETx; LQFP-64_10x10mm_P0.5mm
U102: SST26VF064B-104V/MF; WDFN-8-1EP_6x5mm_P1.27mm_EP3.4x4mm
U201, U202: LTC6820HMS-TRPBF; MS_05-08-1669_ADI
U301: USBLC6-2SC6; SOT-23-6
U401, U402: TCAN1044AVDDFRQ1; TSOT-23-8_HandSoldering
U502: AP2112K-3.3; SOT-23-5
U503: LMR33620CQ5RNXRQ1; RNX0012B
U601: TPL7407LAD; SOIC-16_3.9x9.9mm_P1.27mm

Connections:
+3.3V: C101.1, C102.1, C103.1, C105.1, C107.1, C109.1, C111.1, C112.1, C203.1, C204.1, C205.1, C206.1, C401.1, C403.1, C506.1, J109.1, L101.1, L102.1, R201.2, R506.1, U101.1 (VBAT), U101.16 (VDD), U101.32 (VDD), U101.48 (VDD), U101.64 (VDD), U102.8 (VCC), U201.1 (EN), U201.6 (VDDS), U201.9 (VDD), U201.12 (MSTR), U202.1 (EN), U202.6 (VDDS), U202.9 (VDD), U202.12 (MSTR), U401.5 (VIO), U402.5 (VIO), U502.5 (VOUT)
+5V: C301.1, C402.1, C404.1, C505.1, D301.1 (K), D504.1 (K), R504.1, U301.5 (VBUS), U401.3 (VCC), U402.3 (VCC), U502.1 (VIN), U502.3 (EN)
+12V: C501.1, C503.1, C510.2, C511.2, J103.1, J103.2, J104.12, R505.1, R608.1, R609.1, R610.1, R611.1, R612.1, R613.1, R614.1, R615.1, R616.1, R617.1, R618.1, R619.1, R620.1, R621.1, U503.2 (VIN), U503.9 (EN), U503.10 (VIN), U601.9 (COM)
/BMS SD STATUS: D601.1 (K), J104.1, R608.2, U601.16 (OUT1)
/CAN1_N: U101.62 (FDCAN1_TX), U401.1 (TXD)
/CAN1_P: U101.61 (FDCAN1_RX), U401.4 (RXD)
/CAN2_N: U101.35 (FDCAN2_TX), U402.1 (TXD)
/CAN2_P: U101.34 (FDCAN2_RX), U402.4 (RXD)
/CAN/CAN.1+: J101.4, R401.1, U401.7 (CANH)
/CAN/CAN.1-: J101.3, R402.1, U401.6 (CANL)
/CAN/CAN.2+: J101.2, R403.1, U402.7 (CANH)
/CAN/CAN.2-: J101.1, R404.1, U402.6 (CANL)
/DIG_OUT_0: R601.1, U101.12 (PA0), U601.1 (IN1)
/DIG_OUT_1: R602.1, U101.13 (PA1), U601.2 (IN2)
/DIG_OUT_2: R603.1, U101.14 (PA2), U601.3 (IN3)
/DIG_OUT_3: R604.1, U101.18 (PA4), U601.4 (IN4)
/DIG_OUT_4: R605.1, U101.19 (PA5), U601.5 (IN5)
/DIG_OUT_5: R606.1, U101.44 (PA10), U601.6 (IN6)
/DIG_OUT_6: R607.1, U101.51 (PA15), U601.7 (IN7)
/Digital Outputs and Happy Lights/BMS_OUT_1: D602.1 (K), R609.2, U601.15 (OUT2)
/Digital Outputs and Happy Lights/BMS_OUT_2: D603.1 (K), R610.2, U601.14 (OUT3)
/Digital Outputs and Happy Lights/BMS_OUT_3: D604.1 (K), R611.2, U601.13 (OUT4)
/Digital Outputs and Happy Lights/BMS_OUT_4: D605.1 (K), R612.2, U601.12 (OUT5)
/Digital Outputs and Happy Lights/BMS_OUT_5: D606.1 (K), R613.2, U601.11 (OUT6)
/Digital Outputs and Happy Lights/BMS_OUT_6: D607.1 (K), R614.2, U601.10 (OUT7)
/GPIO_0: J102.1, U101.8 (PC0)
/GPIO_1: J102.2, U101.9 (PC1)
/GPIO_2: J102.3, U101.10 (PC2)
/GPIO_3: J102.4, U101.11 (PC3)
/GPIO_4: J102.5, U101.22 (PC4)
/GPIO_5: J102.6, U101.23 (PC5)
/GPIO_6: J102.7, U101.40 (PC8)
/GPIO_7: J102.8, U101.41 (PC9)
/GPIO_8: J102.9, U101.2 (PC13)
/GPIO_9: J102.10, U101.3 (PC14)
/QSPI.CLK: U101.17 (QUADSPI1_CLK), U102.6 (SCK)
/QSPI.IO0: U101.25 (QUADSPI1_BK1_IO0), U102.5 (IO0)
/QSPI.IO1: U101.24 (QUADSPI1_BK1_IO1), U102.2 (IO1)
/QSPI.IO2: U101.21 (QUADSPI1_BK1_IO2), U102.3 (IO2)
/QSPI.IO3: U101.20 (QUADSPI1_BK1_IO3), U102.7 (IO3)
/QSPI.NCS: U101.33 (QUADSPI1_BK1_NCS), U102.1 (CE#)
/RESET: J109.3, U101.7 (RCC_MCO)
/SPI_CS1: U101.58 (PB5), U201.5 (*CS)
/SPI_CS2: U101.59 (PB6), U202.5 (*CS)
/SWCLK: J109.4, U101.50 (SYS_JTCK-SWCLK)
/SWDIO: J109.2, U101.49 (SYS_JTMS-SWDIO)
/SWO: J109.6, U101.56 (SYS_JTDO-SWO)
/USB/D+: J301.A6 (D+), J301.B6 (D+), U301.4 (I/O2)
/USB/D-: J301.A7 (D-), J301.B7 (D-), U301.6 (I/O1)
/USB/USB.D+: U101.46 (USB_DP), U301.3 (I/O2)
/USB/USB.D-: U101.45 (USB_DM), U301.1 (I/O1)
/isoSPI/INPUT_isoSPI.D+: J201.3, TR201.3 (TX-)
/isoSPI/INPUT_isoSPI.D-: J201.4, TR201.1
/isoSPI/OUTPUT_isoSPI.D+: J201.1, TR201.8 (RX-)
/isoSPI/OUTPUT_isoSPI.D-: J201.2, TR201.6 (RX+)
/isoSPI/SPI2.MISO: R201.1, U101.36 (SPI2_MISO), U201.3 (MISO), U202.3 (MISO)
/isoSPI/SPI2.MOSI: U101.37 (SPI2_MOSI), U201.2 (MOSI), U202.2 (MOSI)
/isoSPI/SPI2.SCK: U101.6 (SPI2_SCK), U201.4 (SCK), U202.4 (SCK)
/isoSPI/isoSPI.D+: R205.2, TR201.14 (TD-), U201.11 (IP)
/isoSPI/isoSPI.D-: R205.1, TR201.16 (TD+), U201.10 (IM)
/isoSPI/isoSPI_2.D+: R206.2, TR201.9 (RD-), U202.11 (IP)
/isoSPI/isoSPI_2.D-: R206.1, TR201.11 (RD+), U202.10 (IM)
GND: C101.2, C102.2, C103.2, C104.2, C105.2, C106.2, C107.2, C108.2, C109.2, C110.2, C111.2, C112.2, C201.2, C202.2, C203.2, C204.2, C205.2, C206.2, C301.2, C401.2, C402.2, C403.2, C404.2, C405.2, C406.2, C501.2, C502.2, C503.2, C504.2, C505.2, C506.2, C507.2, C508.2, C509.2, C510.1, C511.1, D501.1 (K), D502.1 (K), D503.1 (K), H101.1 (1_1), H102.1 (1_1), H103.1 (1_1), H104.1 (1_1), H105.1 (1_1), H106.1 (1_1), J103.3, J103.4, J104.11, J109.5, J301.A1 (GND), J301.A12 (GND), J301.B1 (GND), J301.B12 (GND), J301.SH (SHIELD), R207.2, R208.2, R301.2, R302.2, R502.1, R601.2, R602.2, R603.2, R604.2, R605.2, R606.2, R607.2, U101.15 (VSS), U101.27 (VSSA), U101.31 (VSS), U101.47 (VSS), U101.63 (VSS), U102.4 (VSS), U201.7 (POL), U201.8 (PHA), U201.13 (SLOW), U201.14 (GND), U202.7 (POL), U202.8 (PHA), U202.13 (SLOW), U202.14 (GND), U301.2 (GND), U401.2 (GND), U401.8 (STB), U402.2 (GND), U402.8 (STB), U502.2 (GND), U503.1 (PGND), U503.6 (AGND), U503.11 (PGND), U601.8 (GND)
unnamed: C405.1, R401.2, R402.2
unnamed: C406.1, R403.2, R404.2
unnamed: D301.2 (A), J301.A4 (VBUS), J301.A9 (VBUS), J301.B4 (VBUS), J301.B9 (VBUS)
unnamed: D501.2 (A), R504.2
unnamed: D502.2 (A), R505.2
unnamed: D503.2 (A), R506.2
unnamed: C502.1, C504.1, C508.1, C509.1, D504.2 (A), L501.2, R501.2
unnamed: D601.2 (A), R615.2
unnamed: D602.2 (A), R616.2
unnamed: D603.2 (A), R617.2
unnamed: D604.2 (A), R618.2
unnamed: D605.2 (A), R619.2
unnamed: D606.2 (A), R620.2
unnamed: D607.2 (A), R621.2
unnamed: J301.A5 (CC1), R301.1
unnamed: J301.B5 (CC2), R302.1
unnamed: C202.1, TR201.10 (C_RD)
unnamed: C201.1, TR201.15 (C_TD)
unnamed: C108.1, C110.1, L102.2, U101.29 (VDDA)
unnamed: C104.1, C106.1, L101.2, U101.28 (VREF+)
unnamed: R203.1, U201.16 (IBIAS)
unnamed: R203.2, R207.1, U201.15 (ICMP)
unnamed: R204.1, U202.16 (IBIAS)
unnamed: R204.2, R208.1, U202.15 (ICMP)
unnamed: C512.2, U503.4 (BOOT)
unnamed: R501.1, R502.2, U503.7 (FB)
unnamed: C512.1, L501.1, U503.3 (NC), U503.12 (SW)
unnamed: C507.1, U503.5 (VCC)
