BYU-Racing/bms_hardware/Old_2026_BMS_Files/slave_pcb/default.kicad_pcb

## KiCad design Old_2026_BMS_Files/slave_pcb/default.kicad_pcb (2026-11-10, an earlier design)

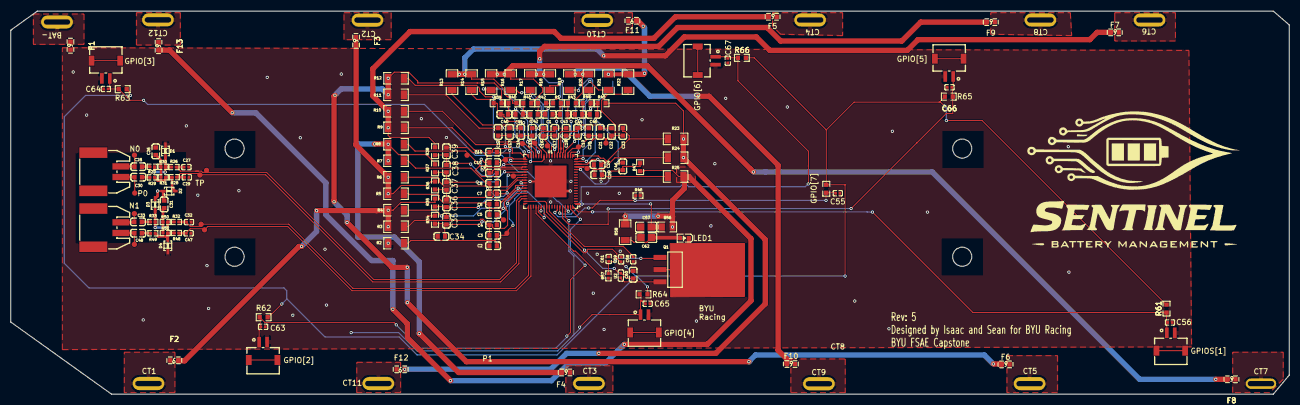
[picture p4: board Old_2026_BMS_Files/slave_pcb/default.kicad_pcb from above]

Board: 2 copper layers, 241.0 x 72.2 mm, 184 parts (0 on the bottom side), 98 nets.

Parts:
C1, C34, C35, C36, C37, C38, C39, C40, C41, C42, C43, C44, C45, C46: 10nF ±10% 50V X7R; C0603
C2, C3, C4, C5, C6, C7, C8, C9, C10, C11, C12, C13, C14, C15, C16, C17, C18, C19, C20, C21, C22, C23, C24, C25, C26, C31: 100nF ±10% 50V X7R; C0603
C27, C29, C32, C47: 330pF ±10% 50V X7R; C0402
C28, C30, C33, C48: 22nF ±10% 50V X7R; C0603
C55, C56, C63, C64, C65, C66, C67: 100nF ±10% 16V X7R; C0402
C57: 10nF ±10% 50V X7R; C0805
C58, C59: 1µF ±10% 25V X5R; C0402
C60: 1µF ±10% 50V X5R; C0603
C61: 10nF ±10% 50V X7R; C0402
C62: 10nF ±10% 100V X7R; C0805
CN1, CN2: CONN-SMD-2P_5023520200
CN3, CN4, CN5, CN6, CN7, CN8: CONN-SMD_S2B-ZR-SM4A
D1, D2, D3, D4: SOD-323_L1.8-W1.3-LS2.5-BI
F1, F2, F3, F4, F5, F6, F7, F8, F9, F10, F11, F12, F13: F0603
LED1: LED0603-RD
Q1: SOT-223-4_L6.5-W3.5-P2.30-LS7.0-BR
R1, R34, R35, R36, R37, R38, R39, R40, R41, R42, R43, R44, R45, R47: 200Ω ±1% 100mW; R0603
R2, R3, R4, R5, R6, R7, R8, R9, R10, R11, R12, R13, R14, R15, R16, R17, R18, R19, R20, R21, R22, R23, R24, R25: 22Ω ±1% 250mW; R1206
R26, R28, R32, R48: 22Ω ±1% 62.5mW; R0402
R27, R29, R33, R49: 15Ω ±1% 62.5mW; R0402
R30, R31, R50, R51: 43Ω ±1% 62.5mW; R0402
R46: R0402
R56: 1kΩ ±1% 125mW; R0805
R57: 10Ω ±1% 62.5mW; R0402
R58: 330Ω ±5% 250mW; R1206
R60, R61, R62, R63, R64, R65, R66: 10kΩ ±1% 100mW; R0603
TP1, TP2, TP3, TP4, TP5, TP6, TP7, TP8, TP9, TP10, TP11, TP12, TP13: voltage_tap
TP14, TP15, TP16, TP17, TP18, TP19, TP20, TP21, TP22, TP23, TP24, TP25, TP26, TP27, TP28, TP29, TP30, TP31, TP32, TP33: TestPoint_Pad_D1.0mm
U1: QFN-72_L10.0-W10.0-P0.50-BL-EP6.0_1
U2: L0402

Connections:
A: C62.1, LED1.2, R58.2
C0: C34.1, C35.2, R34.2, U1.50
C1: C35.1, C36.2, R35.2, U1.48
C2: C36.1, C37.2, R36.2, U1.45
C3: C37.1, C38.2, R37.2, U1.42
C4: C38.1, C39.2, R38.2, U1.39
C5: C39.1, C40.2, R39.2, U1.36
C6: C40.1, C41.2, R40.2, U1.33
C7: C41.1, C42.2, R41.2, U1.30
C8: C1.2, C42.1, R42.2, U1.27
C9: C43.1, C44.2, R43.2, U1.23
C9N: C1.1, C43.2, R1.2, U1.26
C10: C44.1, C45.2, R44.2, U1.20
C11: C45.1, C46.2, R45.2, U1.17
C12: C46.1, R47.2, U1.14
DRIVE: R57.1, U1.58
K: LED1.1, Q1.2, Q1.4
S1N: C2.1, C3.2, R2.2, TP22.1, U1.59
S1P: C3.1, C4.2, R3.2, U1.49
S2N: C4.1, C5.2, R4.2, TP23.1, U1.46
S2P: C5.1, C6.2, R5.2, U1.47
S3N: C6.1, C7.2, R6.2, TP24.1, U1.43
S3P: C7.1, C8.2, R7.2, U1.44
S4N: C8.1, C9.2, R8.2, TP25.1, U1.40
S4P: C9.1, C10.2, R9.2, U1.41
S5N: C10.1, C11.2, R10.2, TP26.1, U1.37
S5P: C11.1, C12.2, R11.2, U1.38
S6N: C12.1, C13.2, R12.2, TP27.1, U1.34
S6P: C13.1, C14.2, R13.2, U1.35
S7N: C14.1, C15.2, R14.2, TP28.1, U1.31
S7P: C15.1, C16.2, R15.2, U1.32
S8N: C16.1, C17.2, R16.2, TP29.1, U1.28
S8P: C17.1, C18.2, R17.2, U1.29
S9N: C18.1, C19.2, R18.2, TP30.1, U1.24
S9P: C19.1, C20.2, R19.2, U1.25
S10N: C20.1, C21.2, R20.2, TP31.1, U1.21
S10P: C21.1, C22.2, R21.2, U1.22
S11N: C22.1, C23.2, R22.2, TP32.1, U1.18
S11P: C23.1, C24.2, R23.2, U1.19
S12N: C24.1, C25.2, R24.2, TP33.1, U1.15
S12P: C25.1, R25.2, U1.16
asic_vp-VCC: C57.1, R56.2, U1.1
base: C61.1, Q1.1, R57.2
bat-: C2.2, C26.2, C27.2, C29.2, C31.2, C32.2, C34.2, C47.2, C55.2, C56.2, C57.2, C58.2, C59.2, C60.2, C61.2, C62.2, C63.2, C64.2, C65.2, C66.2, C67.2, CN3.2, CN4.2, CN5.2, CN6.2, CN7.2, CN8.2, D1.1, D2.1, D3.1, D4.1, F1.2, R2.1, R34.1, R46.2, U1.60, U1.73
cell_tap_1: F2.2, R3.1, R4.1, R35.1
cell_tap_2: F3.2, R5.1, R6.1, R36.1
cell_tap_3: F4.2, R7.1, R8.1, R37.1
cell_tap_4: F5.2, R9.1, R10.1, R38.1
cell_tap_5: F6.2, R11.1, R12.1, R39.1
cell_tap_6: F7.2, R13.1, R14.1, R40.1
cell_tap_7: F8.2, R15.1, R16.1, R41.1
cell_tap_8: F9.2, R1.1, R17.1, R18.1, R42.1
cell_tap_9: F10.2, R19.1, R20.1, R43.1
cell_tap_10: F11.2, R21.1, R22.1, R44.1
cell_tap_11: F12.2, R23.1, R24.1, R45.1
cell_tap_12: F13.2, R25.1, R47.1, R56.1, R58.1
cell_tap_fuses[0]-_1: F1.1, TP1.1
cell_tap_fuses[1]-_1: F2.1, TP2.1
cell_tap_fuses[2]-_1: F3.1, TP3.1
cell_tap_fuses[3]-_1: F4.1, TP4.1
cell_tap_fuses[4]-_1: F5.1, TP5.1
cell_tap_fuses[5]-_1: F6.1, TP6.1
cell_tap_fuses[6]-_1: F7.1, TP7.1
cell_tap_fuses[7]-_1: F8.1, TP8.1
cell_tap_fuses[8]-_1: F9.1, TP9.1
cell_tap_fuses[9]-_1: F10.1, TP10.1
cell_tap_fuses[10]-_1: F11.1, TP11.1
cell_tap_fuses[11]-_1: F12.1, TP12.1
cell_tap_fuses[12]-_1: F13.1, TP13.1
common_mode_cap-common_mode_node-0: C26.1, R30.2, R31.2
common_mode_cap-common_mode_node-1: C31.1, R50.2, R51.2
damping_resistor-point_a-0: D1.2, R26.2, R27.1, R30.1
damping_resistor-point_a-1: D2.2, R28.2, R29.1, R31.1
damping_resistor-point_a-2: D3.2, R32.2, R33.1, R50.1
damping_resistor-point_a-3: D4.2, R48.2, R49.1, R51.1
emitter: Q1.3, U2.1
footprint-net-0: C28.1, R27.2
footprint-net-1: C30.1, R29.2
footprint-net-2: C33.1, R33.2
footprint-net-3: C48.1, R49.2
gpios[0]-output_signal: C56.1, CN3.1, R61.2, U1.72
gpios[1]-output_signal: C63.1, CN4.1, R62.2, U1.71
gpios[2]-output_signal: C64.1, CN5.1, R63.2, U1.70
gpios[3]-output_signal: C65.1, CN6.1, R64.2, U1.69
gpios[4]-output_signal: C66.1, CN7.1, R65.2, U1.68
gpios[5]-output_signal: C67.1, CN8.1, R66.2, U1.67
gpios[6]-output_signal: C55.1, R46.1, R60.2, U1.66
isoA_N: C27.1, R26.1, TP15.1, U1.51
isoA_P: C29.1, R28.1, TP17.1, U1.52
isoB_N: C32.1, R32.1, TP19.1, U1.55
isoB_P: C47.1, R48.1, TP21.1, U1.56
isoSPI_filters[0]-output_pair-contact_N: C28.2, CN1.2, TP14.1
isoSPI_filters[0]-output_pair-contact_P: C30.2, CN1.1, TP16.1
isoSPI_filters[1]-output_pair-contact_N: C33.2, CN2.2, TP18.1
isoSPI_filters[1]-output_pair-contact_P: C48.2, CN2.1, TP20.1
vref1-VCC: C58.1, U1.63
vref2-VCC: C59.1, R60.1, R61.1, R62.1, R63.1, R64.1, R65.1, R66.1, U1.61
vreg-VCC: C60.1, U1.53, U1.62, U2.2
