BYU-Racing/bms_hardware/bms_cell_control_unit/bms_slave_pcb.kicad_pcb

## KiCad design bms_cell_control_unit/bms_slave_pcb.kicad_pcb (2026-08-12)

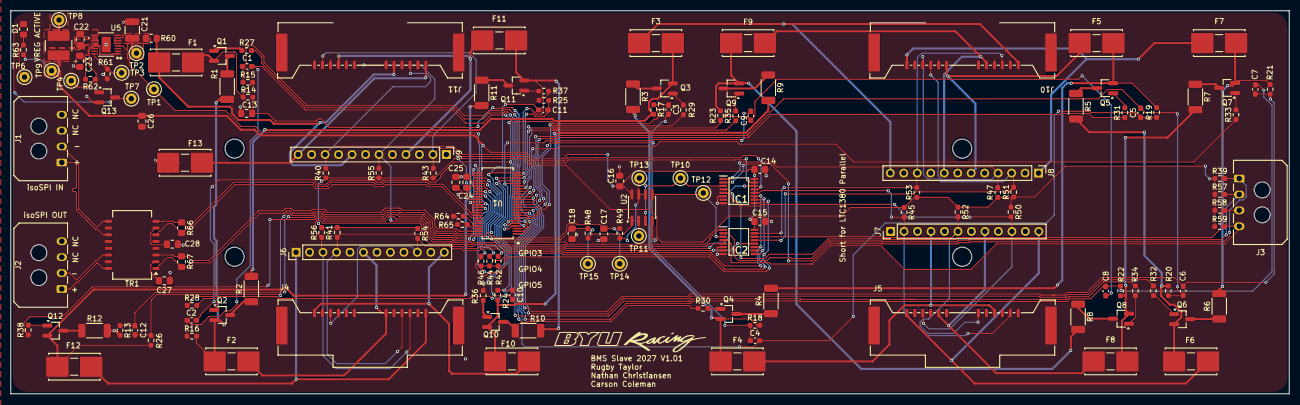
[picture p5: board bms_slave_pcb.kicad_pcb from above]

Board: 2 copper layers, 241.0 x 72.2 mm, 152 parts (0 on the bottom side), 124 nets.

Parts:
C1, C2, C3, C4, C5, C6, C7, C8, C9, C10, C11, C12: 10nF; C_0603_1608Metric_Pad1.08x0.95mm_HandSolder
C13: 100nF; C_0805_2012Metric_Pad1.18x1.45mm_HandSolder
C14: 1uF; R_0805_2012Metric_Pad1.20x1.40mm_HandSolder
C15, C16: 1uf; R_0805_2012Metric_Pad1.20x1.40mm_HandSolder
C17, C18: 10nF; R_0805_2012Metric_Pad1.20x1.40mm_HandSolder
C21: 2.2uF; C_1210_3225Metric_Pad1.33x2.70mm_HandSolder
C22, C23: 22uF; C_0805_2012Metric_Pad1.18x1.45mm_HandSolder
C24, C25, C26: 1uF; C_0805_2012Metric_Pad1.18x1.45mm_HandSolder
C27, C28: 10nF; C_0805_2012Metric_Pad1.18x1.45mm_HandSolder
D1: LED; R_0805_2012Metric_Pad1.20x1.40mm_HandSolder
F1, F13: 500mA; Littelfuse_01550900M_Fuse_Blok_Cartridge
F2, F3, F4, F5, F6, F7, F8, F9, F10, F11, F12: 250mA; Littelfuse_01550900M_Fuse_Blok_Cartridge
IC1, IC2: TMUX1308AQPWRQ1; SOP65P640X120-16N
J1: isoSPI Daisy Chain IN; Molex_Micro-Fit_3.0_43650-0400_1x04_P3.00mm_Horizontal
J2: isoSPI Daisy Chain OUT; Molex_Micro-Fit_3.0_43650-0400_1x04_P3.00mm_Horizontal
J3: Extra Thermistor Connector; Molex_Micro-Fit_3.0_43650-0400_1x04_P3.00mm_Horizontal
J4: Module Top Left FPC Female; FPC_Female_Connector
J5: Module Top Right FPC Female; FPC_Female_Connector
J6, J7, J8, J9: Breadboard pins for testing; PinHeader_1x12_P2.54mm_Vertical
J10: Module Bottom Left FPC Female; FPC_Female_Connector
J11: Module Bottom Right FPC Female; FPC_Female_Connector
L1: 33uH; IND_LQH5BPH330MT0L
Q1, Q2, Q3, Q4, Q5, Q6, Q7, Q8, Q9, Q10, Q11, Q12: BSS308PE; SOT-23_Handsoldering
Q13: 2N7002; SOT-23_Handsoldering
R1, R2, R3, R4, R5, R6, R7, R8, R9, R10, R11, R12: 33; R_2010_5025Metric_Pad1.40x2.65mm_HandSolder
R13, R14, R15, R16, R17, R18, R19, R20, R21, R22, R23, R24, R25, R26, R48, R49: 100; R_0603_1608Metric_Pad0.98x0.95mm_HandSolder
R27, R28, R29, R30, R31, R32, R33, R34, R35, R36, R37, R38: 3.3k; R_0603_1608Metric_Pad0.98x0.95mm_HandSolder
R39, R40, R41, R43, R45, R47, R50, R51, R52, R53, R54, R55, R56, R57, R58, R59: 10k; R_0603_1608Metric_Pad0.98x0.95mm_HandSolder
R42, R44, R46: 4.7K; R_0603_1608Metric_Pad0.98x0.95mm_HandSolder
R60: 470; R_0805_2012Metric_Pad1.20x1.40mm_HandSolder
R61: 374k; R_0603_1608Metric_Pad0.98x0.95mm_HandSolder
R62: 220k; R_0603_1608Metric_Pad0.98x0.95mm_HandSolder
R63: 2.2k; R_0603_1608Metric_Pad0.98x0.95mm_HandSolder
R64, R65: 1k; R_0603_1608Metric_Pad0.98x0.95mm_HandSolder
R66, R67: 100; R_0805_2012Metric_Pad1.20x1.40mm_HandSolder
TP1, TP2, TP3, TP4, TP6, TP7, TP8, TP9, TP10, TP11, TP12, TP13, TP14, TP15: TestPoint; TestPoint_Keystone_5000-5004_Miniature
TR1: TG110I-AE050N5xx; Transformer_Ethernet_Halo_N5_SO-16_7.11x12.7mm
U1: LTC6811HGI-1I-3ZZTRPBF; 05-08-1887_ADI
U2: TLV9002IDR; SOIC-8_3.9x4.9mm_P1.27mm
U5: LT3990HMSEI-5I-PBF; MSOP-16_MSE_LIT

Connections:
/FPC Connections/TH1: IC1.13 (S0), J9.10, J11.10, R40.2
/FPC Connections/TH2: IC1.14 (S1), J4.4, J6.4, R41.2
/FPC Connections/TH3: IC1.15 (S2), J9.2, J11.2, R43.2
/FPC Connections/TH4: IC1.12 (S3), J5.2, J7.2, R45.2
/FPC Connections/TH5: IC1.1 (S4), J8.4, J10.4, R47.2
/FPC Connections/TH6: IC1.5 (S5), J5.10, J7.10, R50.2
/FPC Connections/TH7: IC2.13 (S0), J8.3, J10.3, R51.2
/FPC Connections/TH8: IC2.14 (S1), J5.6, J7.6, R52.2
/FPC Connections/TH9: IC2.15 (S2), J8.10, J10.10, R53.2
/FPC Connections/TH10: IC2.12 (S3), J4.10, J6.10, R54.2
/FPC Connections/TH11: IC2.1 (S4), J9.6, J11.6, R55.2
/FPC Connections/TH12: IC2.5 (S5), J4.3, J6.3, R56.2
/FPC Connections/VBUS1: F12.1, J4.1, J6.1
/FPC Connections/VBUS2: F11.1, J9.4, J11.4
/FPC Connections/VBUS3: F10.1, J4.12, J6.12
/FPC Connections/VBUS4: F9.1, J8.8, J10.8
/FPC Connections/VBUS5: F8.1, J5.8, J7.8
/FPC Connections/VBUS6: F7.1, J8.1, J10.1
/FPC Connections/VBUS7: F6.1, J5.12, J7.12
/FPC Connections/VBUS8: F5.1, J8.6, J10.6
/FPC Connections/VBUS9: F4.1, J5.4, J7.4
/FPC Connections/VBUS10: F3.1, J8.12, J10.12
/FPC Connections/VBUS11: F2.1, J4.6, J6.6
/FPC Connections/VBUS12: F1.1, J9.8, J11.8, R60.2
/FPC Connections/VBUS_GNDREF: F13.1, J9.12, J11.12
/Power Rail/DRIVE: TP1.1 (1_1), U1.38 (DRIVE), U5.4 (EN/UVLO)
/Power Rail/VREG: C14.1, C15.1, C16.1, C23.1, C26.1, IC1.16 (VDD), IC2.16 (VDD), L1.2, R42.1, R44.1, R46.1, R62.1, R63.1, TP9.1 (1_1), U1.37 (VREG), U1.40 (ISOMD), U2.8 (V+), U5.1 (FB/VOUT), U5.2 (FB/VOUT), U5.13 (BD)
/Temperature Sensing/GPIO1(MUX_OUT_1): C18.1, R48.1, TP15.1 (1_1), U1.27 (GPIO1)
/Temperature Sensing/GPIO2(MUX_OUT_2): C17.1, R49.1, TP14.1 (1_1), U1.28 (GPIO2)
/Temperature Sensing/GPIO3: IC1.11 (A0), IC2.11 (A0), R42.2, U1.29 (GPIO3)
/Temperature Sensing/GPIO4: IC1.10 (A1), IC2.10 (A1), R44.2, U1.32 (GPIO4)
/Temperature Sensing/GPIO5: IC1.9 (A2), IC2.9 (A2), R46.2, U1.33 (GPIO5)
/Temperature Sensing/TH0: IC1.2 (S6), J3.1, R39.2
/Temperature Sensing/TH13: IC2.2 (S6), J3.2, R57.2
/Temperature Sensing/TH14: IC1.4 (S7), J3.3, R58.2
/Temperature Sensing/TH15: IC2.4 (S7), J3.4, R59.2
/Temperature Sensing/V_REF2: C24.1, R39.1, R40.1, R41.1, R43.1, R45.1, R47.1, R50.1, R51.1, R52.1, R53.1, R54.1, R55.1, R56.1, R57.1, R58.1, R59.1, U1.34 (VREF2)
/Voltage Taps/C0: C12.2, R13.1, U1.26 (C0)
/Voltage Taps/C1: C11.2, C12.1, R26.1, U1.24 (C1)
/Voltage Taps/C2: C10.2, C11.1, R25.1, U1.22 (C2)
/Voltage Taps/C3: C9.2, C10.1, R24.1, U1.20 (C3)
/Voltage Taps/C4: C8.2, C9.1, R23.1, U1.18 (C4)
/Voltage Taps/C5: C7.2, C8.1, R22.1, U1.16 (C5)
/Voltage Taps/C6: C6.2, C7.1, R21.1, U1.14 (C6)
/Voltage Taps/C7: C5.2, C6.1, R20.1, U1.12 (C7)
/Voltage Taps/C8: C4.2, C5.1, R19.1, U1.10 (C8)
/Voltage Taps/C9: C3.2, C4.1, R18.1, U1.8 (C9)
/Voltage Taps/C10: C2.2, C3.1, R17.1, U1.6 (C10)
/Voltage Taps/C11: C1.2, C2.1, R16.1, U1.4 (C11)
/Voltage Taps/C12: C1.1, R15.1, U1.2 (C12)
/Voltage Taps/S1: R38.1, U1.25 (S1)
/Voltage Taps/S2: R37.1, U1.23 (S2)
/Voltage Taps/S3: R36.1, U1.21 (S3)
/Voltage Taps/S4: R35.1, U1.19 (S4)
/Voltage Taps/S5: R34.1, U1.17 (S5)
/Voltage Taps/S6: R33.1, U1.15 (S6)
/Voltage Taps/S7: R32.1, U1.13 (S7)
/Voltage Taps/S8: R31.1, U1.11 (S8)
/Voltage Taps/S9: R30.1, U1.9 (S9)
/Voltage Taps/S10: R29.1, U1.7 (S10)
/Voltage Taps/S11: R28.1, U1.5 (S11)
/Voltage Taps/S12: R27.1, U1.3 (S12)
/Voltage Taps/VI+: C13.1, R14.1, U1.1 (V+)
/isoSPI Daisy Chain/+: R66.2, TR1.6 (RX-), U1.42 (SCK(IPA))
/isoSPI Daisy Chain/-: R66.1, TR1.8 (RX+), U1.41 (CSB(IMA))
/isoSPI Daisy Chain/I+: R67.2, TR1.1 (TX-), U1.48 (IPB)
/isoSPI Daisy Chain/I-: R67.1, TR1.3 (TX+), U1.47 (IMB)
/isoSPI Daisy Chain/IBIAS: R64.2, U1.45 (IBIAS)
/isoSPI Daisy Chain/ICMP: R64.1, R65.2, U1.46 (ICMP)
/isoSPI Daisy Chain/V_REF1: C25.1, U1.35 (VREF1)
/isoSPI Daisy Chain/isoSPIAI+: J1.1, TR1.11 (RD-)
/isoSPI Daisy Chain/isoSPIAI-: J1.2, TR1.9 (RD+)
/isoSPI Daisy Chain/isoSPIBI+: J2.1, TR1.16 (TD-)
/isoSPI Daisy Chain/isoSPIBI-: J2.2, TR1.14 (TD+)
GNDREF: C13.2, C14.2, C15.2, C16.2, C17.2, C18.2, C21.2, C23.2, C24.2, C25.2, C26.2, C27.2, C28.2, F13.2, IC1.6 (~EN), IC1.8 (GND), IC2.6 (~EN), IC2.8 (GND), J4.2, J4.5, J4.7, J4.9, J4.11, J5.1, J5.3, J5.5, J5.7, J5.9, J5.11, J6.2, J6.5, J6.7, J6.9, J6.11, J7.1, J7.3, J7.5, J7.7, J7.9, J7.11, J8.2, J8.5, J8.7, J8.9, J8.11, J9.1, J9.3, J9.5, J9.7, J9.9, J9.11, J10.2, J10.5, J10.7, J10.9, J10.11, J11.1, J11.3, J11.5, J11.7, J11.9, J11.11, Q13.2 (S), R12.2, R13.2, R61.2, R65.1, U1.30 (V-), U1.31 (V-), U1.36 (DTEN), U2.4 (V-), U5.8 (GND), U5.17
unnamed: D1.2 (A), R63.2, TP6.1 (1_1)
unnamed: D1.1 (K), Q13.3 (D), TP7.1 (1_1)
unnamed: IC1.3 (D), TP10.1 (1_1), U2.3
unnamed: IC2.3 (D), TP12.1 (1_1), U2.5
unnamed: Q1.3 (D), R1.1
unnamed: Q1.1 (G), R27.2
unnamed: F1.2, Q1.2 (S), R14.2, R15.2
unnamed: Q2.3 (D), R2.1
unnamed: Q2.1 (G), R28.2
unnamed: F2.2, Q2.2 (S), R1.2, R16.2
unnamed: Q3.3 (D), R3.1
unnamed: Q3.1 (G), R29.2
unnamed: F3.2, Q3.2 (S), R2.2, R17.2
unnamed: Q4.3 (D), R4.1
unnamed: Q4.1 (G), R30.2
unnamed: F4.2, Q4.2 (S), R3.2, R18.2
unnamed: Q5.3 (D), R5.1
unnamed: Q5.1 (G), R31.2
unnamed: F5.2, Q5.2 (S), R4.2, R19.2
unnamed: Q6.3 (D), R6.1
unnamed: Q6.1 (G), R32.2
unnamed: F6.2, Q6.2 (S), R5.2, R20.2
unnamed: Q7.3 (D), R7.1
unnamed: Q7.1 (G), R33.2
unnamed: F7.2, Q7.2 (S), R6.2, R21.2
unnamed: Q8.3 (D), R8.1
unnamed: Q8.1 (G), R34.2
unnamed: F8.2, Q8.2 (S), R7.2, R22.2
unnamed: Q9.3 (D), R9.1
unnamed: Q9.1 (G), R35.2
unnamed: F9.2, Q9.2 (S), R8.2, R23.2
unnamed: Q10.3 (D), R10.1
unnamed: Q10.1 (G), R36.2
unnamed: F10.2, Q10.2 (S), R9.2, R24.2
unnamed: Q11.3 (D), R11.1
unnamed: Q11.1 (G), R37.2
unnamed: F11.2, Q11.2 (S), R10.2, R25.2
unnamed: Q12.3 (D), R12.1
unnamed: Q12.1 (G), R38.2
unnamed: F12.2, Q12.2 (S), R11.2, R26.2
unnamed: Q13.1 (G), R62.2, TP4.1 (1_1), U5.14 (PG)
unnamed: R48.2, TP11.1 (1_1), U2.1, U2.2
unnamed: R49.2, TP13.1 (1_1), U2.6, U2.7
unnamed: C28.1, TR1.7 (C_RX)
unnamed: C27.1, TR1.2 (C_TX)
unnamed: C22.1, U5.11 (BOOST)
unnamed: R61.1, TP3.1 (1_1), U5.16 (RT)
unnamed: C22.2, L1.1, TP8.1 (1_1), U5.9 (SW)
unnamed: C21.1, R60.1, TP2.1 (1_1), U5.6 (VIN)
