BYU-Racing/bms_hardware/bms_cell_emulator_board/bms_cell_emulator_board.kicad_pcb

## KiCad design bms_cell_emulator_board/bms_cell_emulator_board.kicad_pcb (2026-09-30)

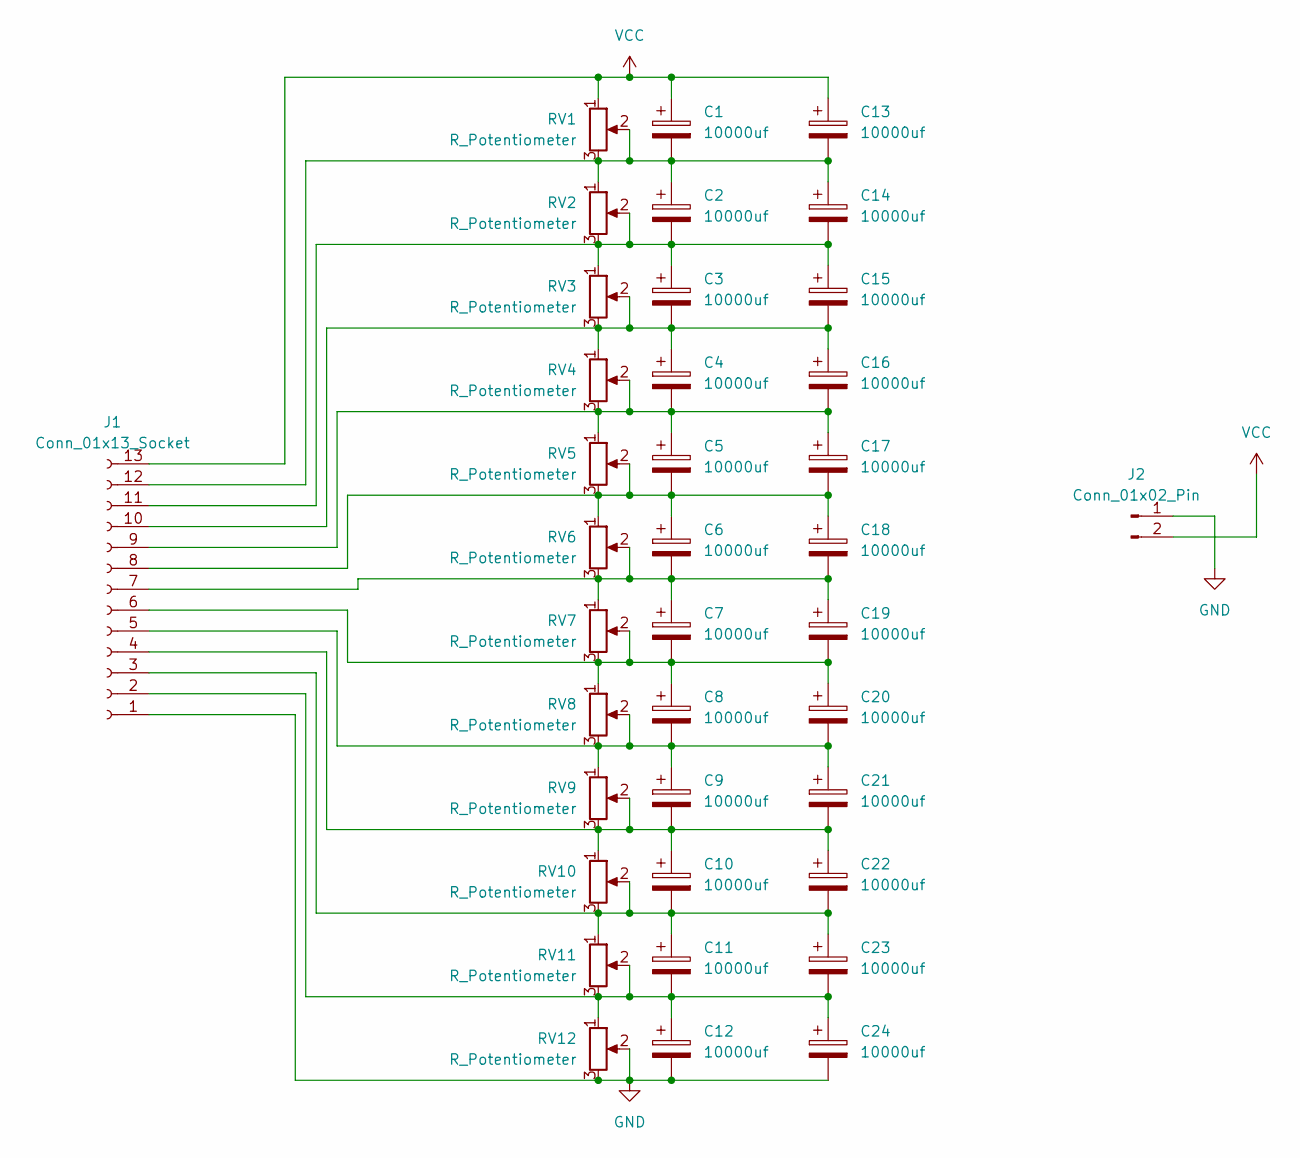
[picture p6: schematic bms_cell_emulator_board.kicad_sch]

Parts:
C1, C2, C3, C4, C5, C6, C7, C8, C9, C10, C11, C12, C13, C14, C15, C16, C17, C18, C19, C20, C21, C22, C23, C24: 10000uf; CP_Radial_D16.0mm_P7.50mm
J1: Conn_01x13_Socket; PinHeader_1x13_P2.54mm_Vertical
J2: Conn_01x02_Pin; AMASS_XT30U-M_1x02_P5.0mm_Vertical
RV1, RV2, RV3, RV4, RV5, RV6, RV7, RV8, RV9, RV10, RV11, RV12: R_Potentiometer; Potentiometer_Bourns_3386W_Horizontal

Connections:
GND: C12.2, C24.2, J1.1, J2.1, RV12.2, RV12.3
unnamed: C11.2, C12.1, C23.2, C24.1, J1.2, RV11.2, RV11.3, RV12.1
unnamed: C10.2, C11.1, C22.2, C23.1, J1.3, RV10.2, RV10.3, RV11.1
unnamed: C9.2, C10.1, C21.2, C22.1, J1.4, RV9.2, RV9.3, RV10.1
unnamed: C8.2, C9.1, C20.2, C21.1, J1.5, RV8.2, RV8.3, RV9.1
unnamed: C7.2, C8.1, C19.2, C20.1, J1.6, RV7.2, RV7.3, RV8.1
unnamed: C6.2, C7.1, C18.2, C19.1, J1.7, RV6.2, RV6.3, RV7.1
unnamed: C5.2, C6.1, C17.2, C18.1, J1.8, RV5.2, RV5.3, RV6.1
unnamed: C4.2, C5.1, C16.2, C17.1, J1.9, RV4.2, RV4.3, RV5.1
unnamed: C3.2, C4.1, C15.2, C16.1, J1.10, RV3.2, RV3.3, RV4.1
unnamed: C2.2, C3.1, C14.2, C15.1, J1.11, RV2.2, RV2.3, RV3.1
unnamed: C1.2, C2.1, C13.2, C14.1, J1.12, RV1.2, RV1.3, RV2.1
VCC: C1.1, C13.1, J1.13, J2.2, RV1.1

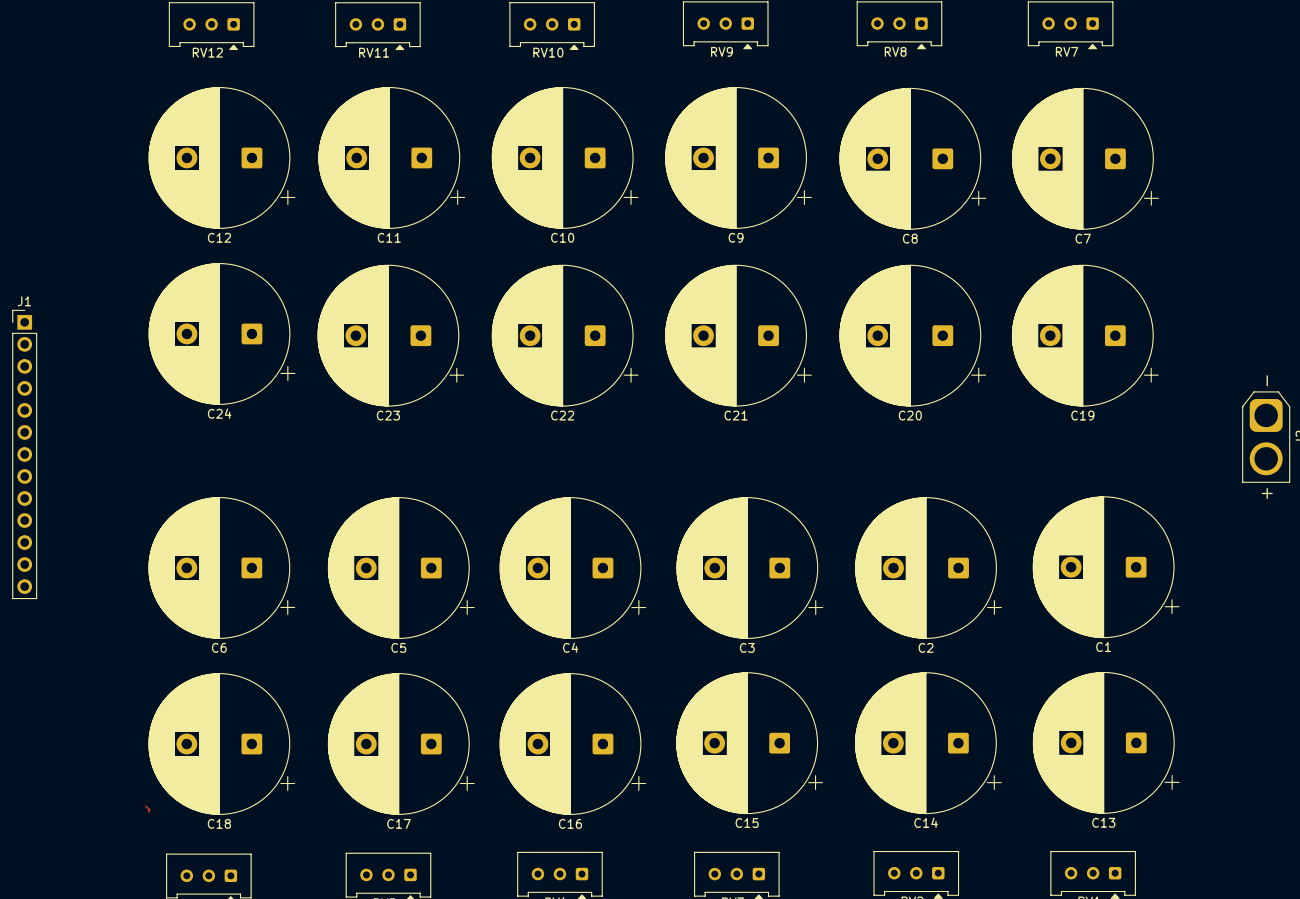
[picture p7: board bms_cell_emulator_board.kicad_pcb from above]

Board: 2 copper layers, 38 parts (0 on the bottom side), 13 nets.
