BYU-Racing/bms_hardware/bms_flex_pcb/bms_flex_pcb.kicad_pcb

## KiCad design bms_flex_pcb/bms_flex_pcb.kicad_pcb (2026-08-19)

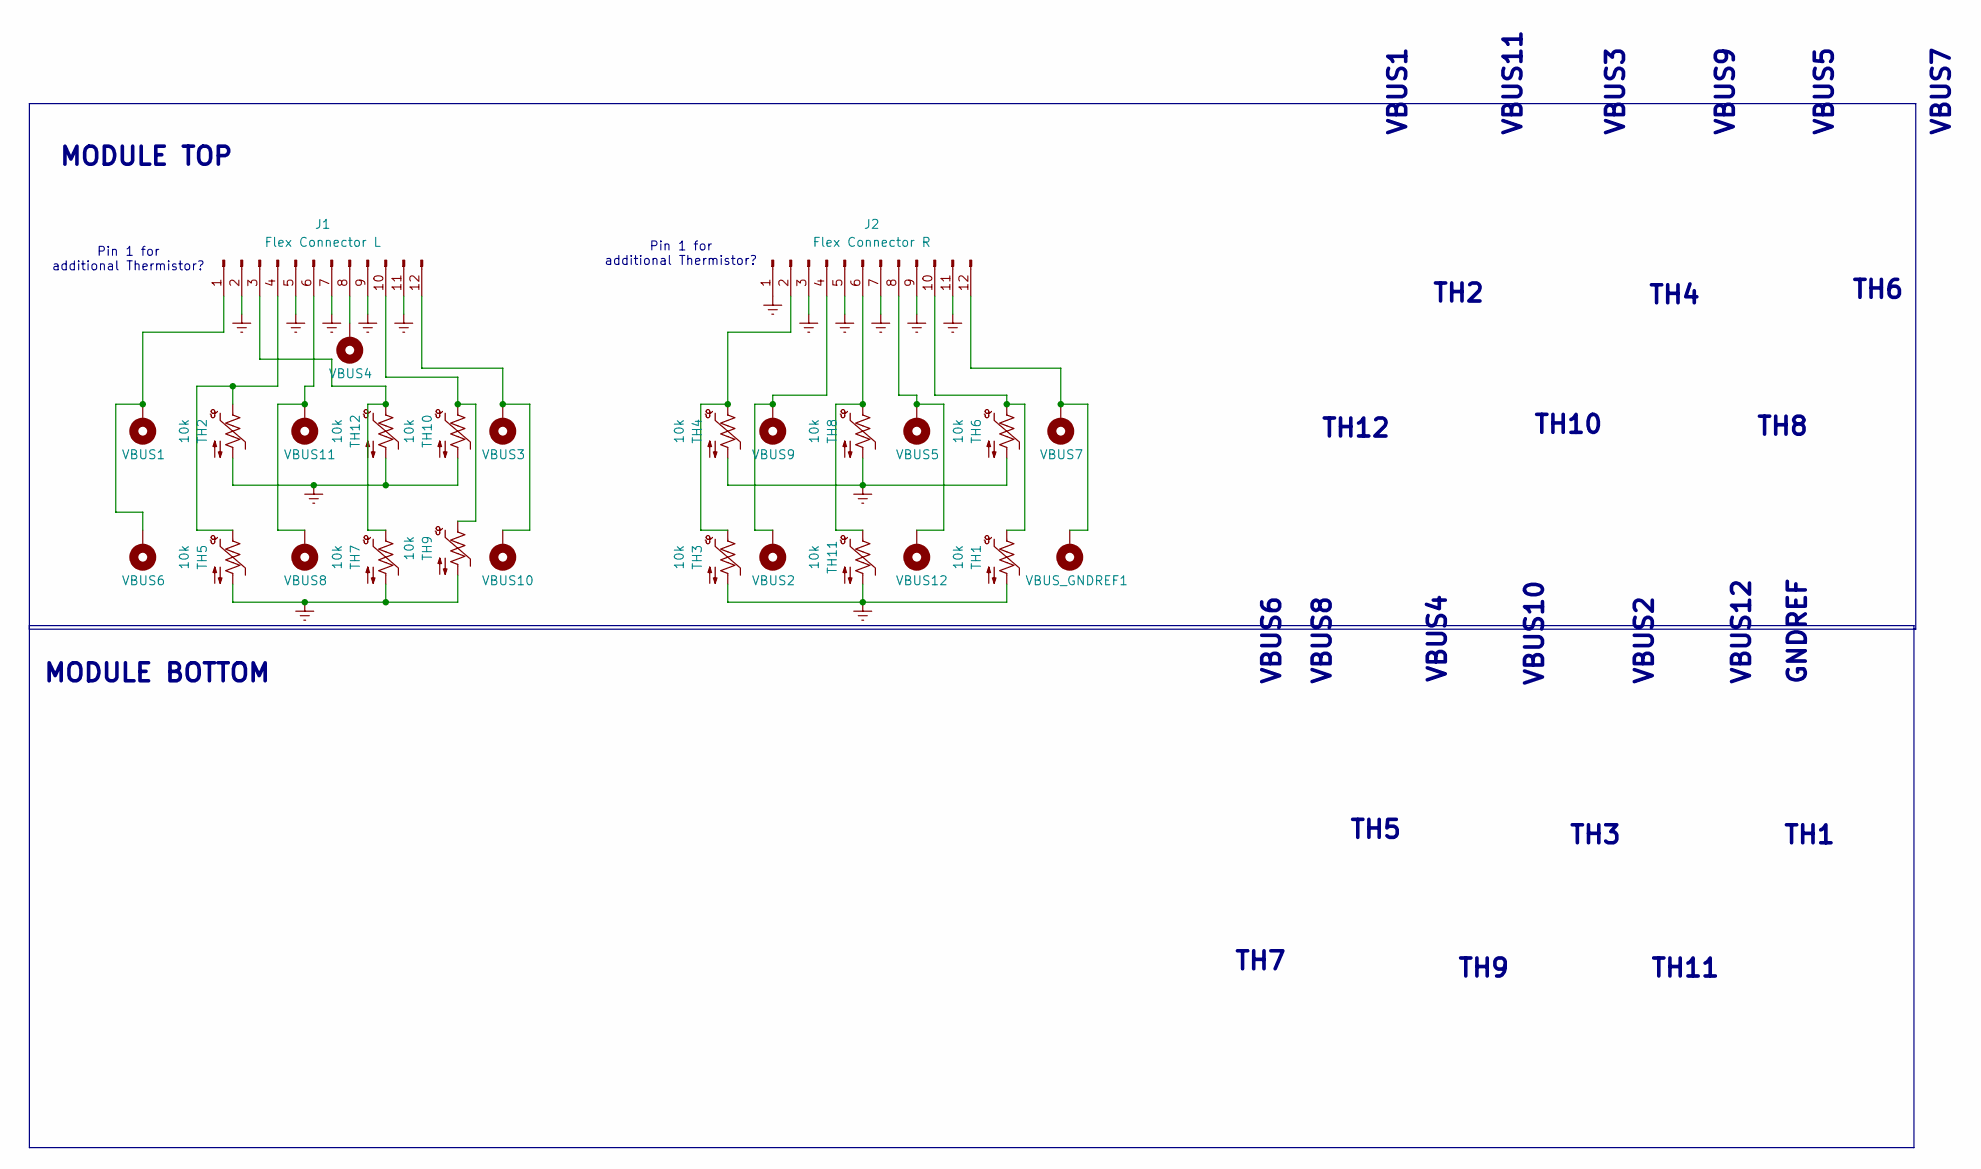
[picture p8: schematic bms_flex_pcb.kicad_sch]

Parts:
J1: Flex Connector L; Molex_2190190120_FPC_Board_Connect
J2: Flex Connector R; Molex_2190190120_FPC_Board_Connect
TH1, TH2, TH3, TH4, TH5, TH6, TH7, TH8, TH9, TH10, TH11, TH12: 10k; R_0603_1608Metric_Pad0.98x0.95mm_HandSolder
VBUS1, VBUS2, VBUS3, VBUS4, VBUS5, VBUS6, VBUS7, VBUS8, VBUS9, VBUS10, VBUS11, VBUS12: MountingHole_Pad; 2026_BMS_Voltage_Tap
VBUS_GNDREF1: MountingHole_Pad; 2026_BMS_Voltage_Tap

Connections:
GNDREF: J1.2, J1.5, J1.7, J1.9, J1.11, J2.1, J2.3, J2.5, J2.7, J2.9, J2.11, TH1.2, TH2.2, TH3.2, TH4.2, TH5.2, TH6.2, TH7.2, TH8.2, TH9.2, TH10.2, TH11.2, TH12.2
unnamed: J1.1, VBUS1.1 (1_1), VBUS6.1 (1_1)
unnamed: J1.3, TH7.1, TH12.1
unnamed: J1.4, TH2.1, TH5.1
unnamed: J1.6, VBUS8.1 (1_1), VBUS11.1 (1_1)
unnamed: J1.8, VBUS4.1 (1_1)
unnamed: J1.10, TH9.1, TH10.1
unnamed: J1.12, VBUS3.1 (1_1), VBUS10.1 (1_1)
unnamed: J2.2, TH3.1, TH4.1
unnamed: J2.4, VBUS2.1 (1_1), VBUS9.1 (1_1)
unnamed: J2.6, TH8.1, TH11.1
unnamed: J2.8, VBUS5.1 (1_1), VBUS12.1 (1_1)
unnamed: J2.10, TH1.1, TH6.1
unnamed 13: J2.12, VBUS7.1 (1_1), VBUS_GNDREF1.1; also elsewhere on the board

Notes on the sheet:
GNDREF
TH12
TH7
TH10
MODULE BOTTOM
TH2
VBUS3
VBUS12
VBUS10
TH6
MODULE TOP
Pin 1 for additional Thermistor?
VBUS5
VBUS11
VBUS9
TH8
TH5
TH4
VBUS7
VBUS1
VBUS8
VBUS6
TH3
TH11
VBUS4
TH1
VBUS2
TH9

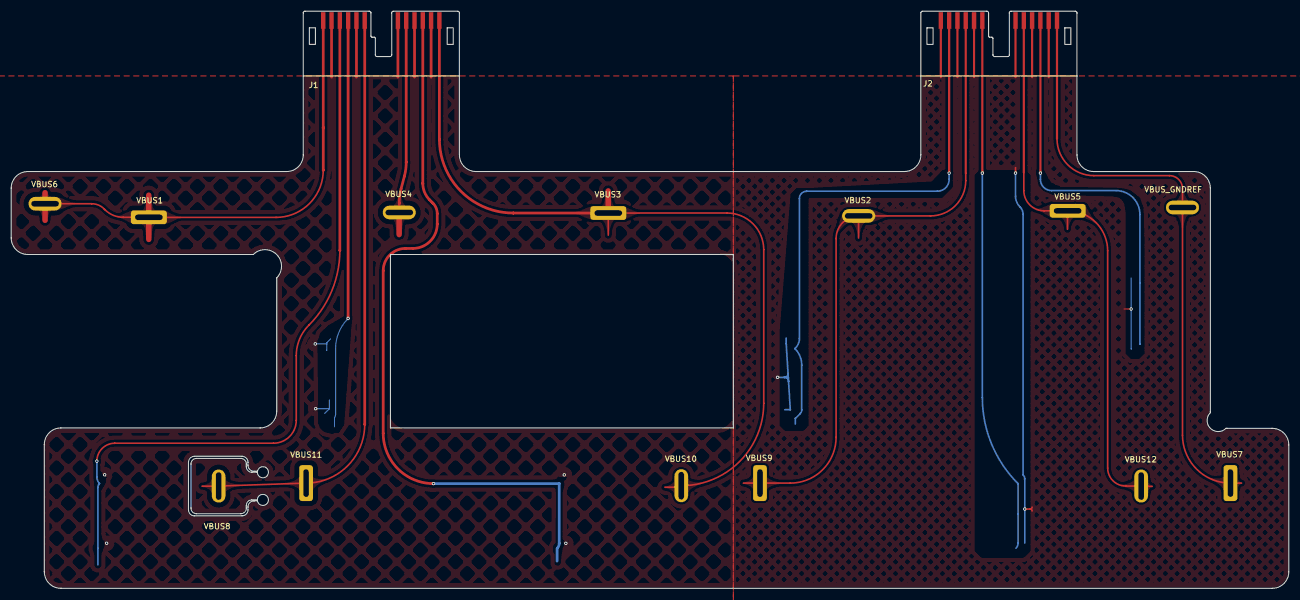
[picture p9: board bms_flex_pcb.kicad_pcb from above]

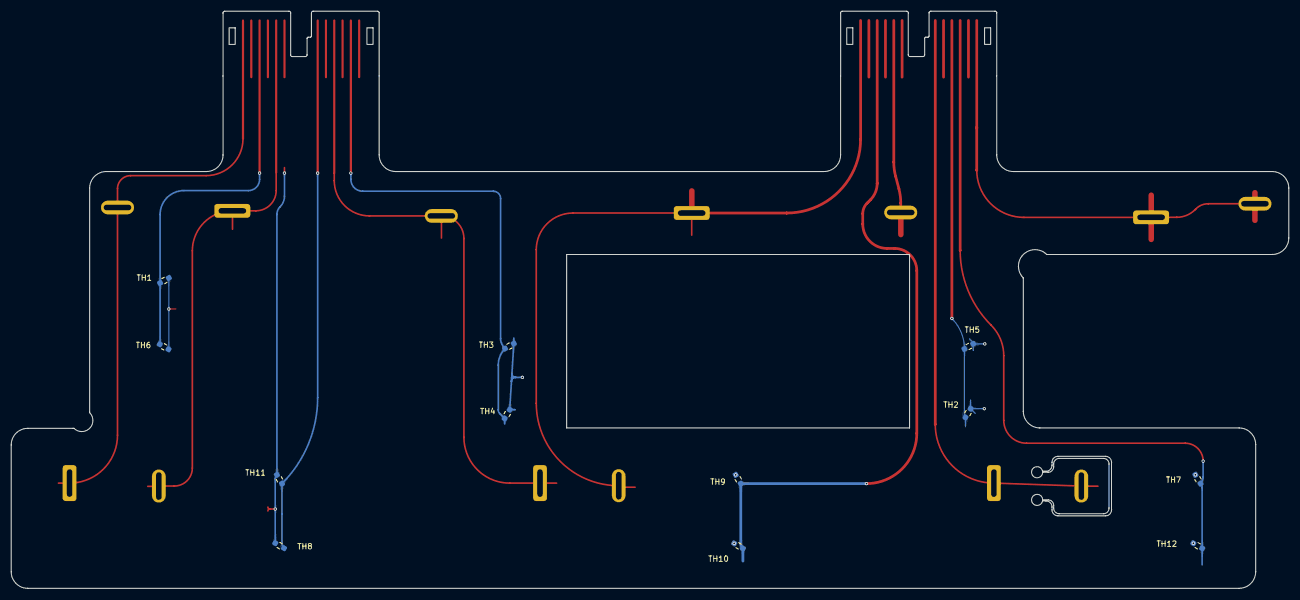
[picture p10: board bms_flex_pcb.kicad_pcb from below]

Board: 2 copper layers, 231.0 x 104.3 mm, 27 parts (12 on the bottom side), 14 nets.

Other parts of the board:
VBUS_GNDREF: MountingHole_Pad; 2026_BMS_Voltage_Tap

Their connections:
unnamed 13: VBUS_GNDREF.1 (1_1); also elsewhere on the board
