BYU-Racing/bms_hardware/Old_2026_BMS_Files/master_pcb/default.kicad_pcb

## KiCad design Old_2026_BMS_Files/master_pcb/default.kicad_pcb (2026-11-10, an earlier design)

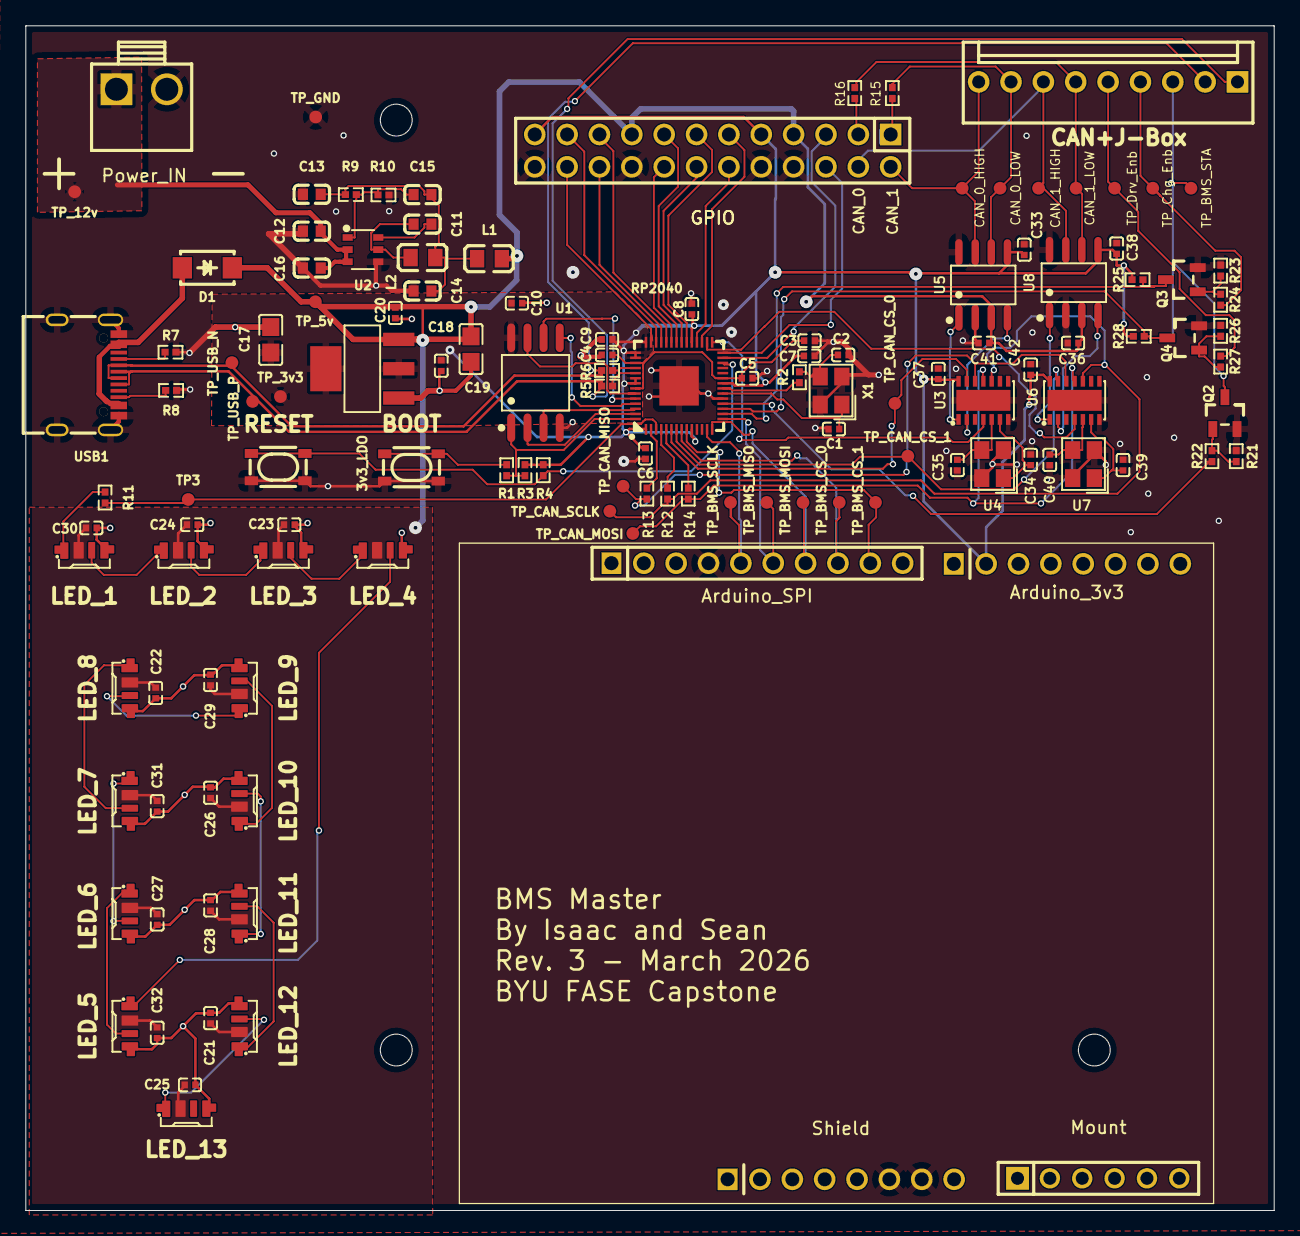
[picture p11: board Old_2026_BMS_Files/master_pcb/default.kicad_pcb from above]

Board: 2 copper layers, 98.0 x 93.0 mm, 130 parts (0 on the bottom side), 91 nets.

Parts:
3v3_LDO: SOT-223_L6.5-W3.5-P2.30-LS7.0-BR
Arduino_3v3: HDR-TH_8P-P2.54-V-F
Arduino_SPI: HDR-TH_10P-P2.54-V-F
BOOT: KEY-SMD_4P-L4.2-W3.2-P2.20-LS4.6
C1, C2, C34, C35, C39, C40: 22pF ±5% 50V C0G; C0402
C3, C4, C5, C6, C7, C8, C9, C10: 1µF ±10% 25V X5R; C0402
C11, C16: 100nF ±10% 50V X7R; C0603
C12: 10µF ±10% 10V X5R; C0603
C13, C14: 22µF ±20% 6.3V X5R; C0603
C15: 47pF ±5% 50V C0G; C0603
C17, C19: 10µF ±10% 25V X5R; C0805
C18, C20, C21, C22, C23, C24, C25, C26, C27, C28, C29, C30, C31, C32, C33, C36, C37, C38, C41, C42: 100nF ±10% 16V X7R; C0402
CAN+J-Box: CONN-TH_9P-P2.54_MOLEX_22232091
CAN_0_HIGH, CAN_0_LOW, CAN_1_HIGH, CAN_1_LOW: TestPoint_Pad_D1.0mm
D1: SMA_L4.2-W2.6-LS5.0-RD_1
GPIO: HDR-TH_24P-P2.54-V-M-R2-C12-S2.54
L1: L0805
L2: 6.8µH ±20% 550mA 270mΩ; L0805
LED_1, LED_2, LED_3, LED_4, LED_5, LED_6, LED_7, LED_8, LED_9, LED_10, LED_11, LED_12, LED_13: LED-SMD_4P-L4.0-W1.6-L
Mount: HDR-TH_6P-P2.54-V-F
Power_IN: CONN-TH_B2P-VH-LF-SN
Q2, Q3, Q4: SOT-23-3_L2.9-W1.3-P1.90-LS2.4-TR
R1, R2: 1kΩ ±1% 62.5mW; R0402
R3, R4, R25, R28: 10kΩ ±1% 62.5mW; R0402
R5, R6: 27Ω ±1% 62.5mW; R0402
R7, R8, R22: 4.7kΩ ±1% 62.5mW; R0402
R9: 158kΩ ±1% 62.5mW; R0402
R10: 30.1kΩ ±1% 62.5mW; R0402
R11: 150Ω ±1% 62.5mW; R0402
R12, R13, R14: 22Ω ±1% 62.5mW; R0402
R15, R16: 120Ω ±1% 62.5mW; R0402
R21, R24, R27: 100kΩ ±1% 62.5mW; R0402
R23, R26: 1MΩ ±1% 62.5mW; R0402
RESET: KEY-SMD_4P-L4.2-W3.2-P2.20-LS4.6
RP2040: LQFN-56_L7.0-W7.0-P0.4-EP
Shield: HDR-TH_8P-P2.54-V-F
TP3: TestPoint_Pad_D1.0mm
TP_3v3, TP_5v, TP_12v: TestPoint_Pad_D1.0mm
TP_BMS_CS_0, TP_BMS_CS_1: TestPoint_Pad_D1.0mm
TP_BMS_MISO: TestPoint_Pad_D1.0mm
TP_BMS_MOSI: TestPoint_Pad_D1.0mm
TP_BMS_SCLK: TestPoint_Pad_D1.0mm
TP_BMS_STA: TestPoint_Pad_D1.0mm
TP_CAN_CS_0, TP_CAN_CS_1: TestPoint_Pad_D1.0mm
TP_CAN_MISO: TestPoint_Pad_D1.0mm
TP_CAN_MOSI: TestPoint_Pad_D1.0mm
TP_CAN_SCLK: TestPoint_Pad_D1.0mm
TP_Chg_Enb: TestPoint_Pad_D1.0mm
TP_Drv_Enb: TestPoint_Pad_D1.0mm
TP_GND: TestPoint_Pad_D1.0mm
TP_USB_N: TestPoint_Pad_D1.0mm
TP_USB_P: TestPoint_Pad_D1.0mm
U1: SOIC-8_L5.3-W5.3-P1.27-LS8.0-BL
U2: TSOT-23-6_L2.9-W1.6-P0.95-LS2.8-BR
U3, U6: VDFN-14_L4.5-W3.0-P0.65-BL-EP
U4, U7: CRYSTAL-SMD_4P-L3.2-W2.5-BL
U5, U8: SOIC-8_L4.9-W3.9-P1.27-LS6.0-BL
USB1: USB-C-SMD_KH-TYPE-C-16P
X1: CRYSTAL-SMD_4P-L3.2-W2.5-BL

Connections:
3V: 3v3_LDO.2, 3v3_LDO.4, Arduino_3v3.2, C6.1, C7.1, C8.1, C9.1, C10.1, C17.1, C18.1, C33.1, C37.1, C38.1, C42.1, GPIO.9, GPIO.23, R3.1, R4.1, R25.1, R28.1, RP2040.1, RP2040.10, RP2040.22, RP2040.33, RP2040.42, RP2040.43, RP2040.44, RP2040.48, RP2040.49, TP_3v3.1, U1.8, U3.14, U5.5, U6.14, U8.5
5V: 3v3_LDO.3, C19.1, C20.1, C21.1, C22.1, C23.1, C24.1, C25.1, C26.1, C27.1, C28.1, C29.1, C30.1, C31.1, C32.1, C36.1, C41.1, D1.1, GPIO.7, GPIO.17, L1.2, LED_1.2, LED_2.2, LED_3.2, LED_4.2, LED_5.2, LED_6.2, LED_7.2, LED_8.2, LED_9.2, LED_10.2, LED_11.2, LED_12.2, LED_13.2, TP_5v.1, U5.3, U8.3
12V: C12.1, C16.1, Power_IN.1, TP_12v.1, U2.2, U2.3
A5: R7.1, USB1.A5
B5: R8.1, USB1.B5
BMS_status: CAN+J-Box.3, Q2.3, TP_BMS_STA.1
BST: C11.1, U2.6
CAN_CS_0: RP2040.6, TP_CAN_CS_0.1, U3.13
CAN_CS_1: RP2040.7, TP_CAN_CS_1.1, U6.13
FB: C15.2, R9.2, R10.1, U2.1
GND: 3v3_LDO.1, Arduino_SPI.4, BOOT.1, BOOT.2, C1.2, C2.2, C3.2, C4.2, C5.2, C6.2, C7.2, C8.2, C9.2, C10.2, C12.2, C13.2, C14.2, C16.2, C17.2, C18.2, C19.2, C20.2, C21.2, C22.2, C23.2, C24.2, C25.2, C26.2, C27.2, C28.2, C29.2, C30.2, C31.2, C32.2, C33.2, C34.2, C35.2, C36.2, C37.2, C38.2, C39.2, C40.2, C41.2, C42.2, GPIO.8, GPIO.10, GPIO.18, GPIO.24, LED_1.4, LED_2.4, LED_3.4, LED_4.4, LED_5.4, LED_6.4, LED_7.4, LED_8.4, LED_9.4, LED_10.4, LED_11.4, LED_12.4, LED_13.4, Power_IN.2, Q2.1, Q3.1, Q4.1, R7.2, R8.2, R10.2, R21.2, R23.2, R26.2, RESET.1, RESET.2, RP2040.19, RP2040.57, Shield.6, Shield.7, TP_GND.1, U1.4, U2.4, U3.7, U3.15, U4.2, U4.4, U5.2, U5.8, U6.7, U6.15, U7.2, U7.4, U8.2, U8.8, USB1.1, USB1.2, USB1.3, USB1.4, USB1.A1, USB1.A12, USB1.B1, USB1.B12, X1.2, X1.4
RX: GPIO.6, RP2040.28
SCL: GPIO.12, RP2040.32
SDA: GPIO.11, RP2040.31
SW: C11.2, L2.1, U2.5
TX: GPIO.5, RP2040.27
TestPoint_LED_DATA-contact: R11.1, RP2040.3, TP3.1
TestPoint_SPI1_CS_0-contact: Arduino_SPI.8, RP2040.8, TP_BMS_CS_0.1
TestPoint_SPI1_CS_1-contact: Arduino_SPI.9, RP2040.9, TP_BMS_CS_1.1
TestPoint_SPI1_MISO-contact: Arduino_SPI.6, RP2040.15, TP_BMS_MISO.1
USB_DM: R6.2, RP2040.46
USB_DP: R5.2, RP2040.47
USB_D_N: CAN+J-Box.2, R6.1, TP_USB_N.1, USB1.A7, USB1.B7
USB_D_P: CAN+J-Box.1, R5.1, TP_USB_P.1, USB1.A6, USB1.B6
XIN: C1.1, RP2040.20, X1.1
XOUT: R2.1, RP2040.21
bms_status_base_pulldown-B: Q2.2, R21.1, R22.2
boot_btn-output: BOOT.3, BOOT.4, R1.1
button-output: R4.2, RESET.3, RESET.4, RP2040.26
c_osc_2-OSC2: C2.1, R2.2, X1.3
can0-OSC1: C34.1, U3.6, U4.1
can0-OSC2: C35.1, U3.5, U4.3
can0-RXCAN: U3.2, U5.4
can0-TXCAN: U3.1, U5.1
can0-nint: RP2040.29, U3.4
can1-OSC1: C39.1, U6.6, U7.1
can1-OSC2: C40.1, U6.5, U7.3
can1-RXCAN: U6.2, U8.4
can1-TXCAN: U6.1, U8.1
can1-nint: RP2040.30, U6.4
can_0_high: CAN+J-Box.9, CAN_0_HIGH.1, GPIO.2, U5.7
can_0_low: CAN+J-Box.8, CAN_0_LOW.1, R15.2, U5.6
can_0_terminator-_1: GPIO.1, R15.1
can_1_high: CAN+J-Box.7, CAN_1_HIGH.1, GPIO.4, U8.7
can_1_low: CAN+J-Box.6, CAN_1_LOW.1, R16.2, U8.6
can_1_terminator-_3: GPIO.3, R16.1
charge_enable: CAN+J-Box.4, R24.1, TP_Chg_Enb.1
charge_enable_base_pulldown-B: Q3.2, R23.1, R24.2
charge_enable_pullup-C: Q3.3, R25.2, RP2040.16
cs: R1.2, R3.2, RP2040.56, U1.1
drive_enable: CAN+J-Box.5, R27.1, TP_Drv_Enb.1
drive_enable_base_pulldown-B: Q4.2, R26.1, R27.2
drive_enable_pullup-C: Q4.3, R28.2, RP2040.17
footprint-DIN-0: LED_1.1, R11.2
footprint-DIN-1: LED_1.3, LED_2.1
footprint-DIN-2: LED_10.3, LED_11.1
footprint-DIN-3: LED_11.3, LED_12.1
footprint-DIN-4: LED_12.3, LED_13.1
footprint-DIN-5: LED_2.3, LED_3.1
footprint-DIN-6: LED_3.3, LED_4.1
footprint-DIN-7: LED_4.3, LED_5.1
footprint-DIN-8: LED_5.3, LED_6.1
footprint-DIN-9: LED_6.3, LED_7.1
footprint-DIN-10: LED_7.3, LED_8.1
footprint-DIN-11: LED_8.3, LED_9.1
footprint-DIN-12: LED_9.3, LED_10.1
gpio0: R13.1, RP2040.2
gpio2: R12.1, RP2040.4
gpio3: R14.1, RP2040.5
gpio15: R22.1, RP2040.18
gpio22: GPIO.13, RP2040.34
gpio23: GPIO.14, RP2040.35
gpio24: GPIO.15, RP2040.36
gpio25: GPIO.16, RP2040.37
gpio26_a0: GPIO.19, RP2040.38
gpio27_a1: GPIO.20, RP2040.39
gpio28_a2: GPIO.21, RP2040.40
gpio29_a3: GPIO.22, RP2040.41
io0: RP2040.53, U1.5
io1: RP2040.55, U1.2
io2: RP2040.54, U1.3
io3: RP2040.51, U1.7
power_1V-VCC: C3.1, C4.1, C5.1, RP2040.23, RP2040.45, RP2040.50
sclk: RP2040.52, U1.6
spi1-MOSI: Arduino_SPI.7, RP2040.14, TP_BMS_MOSI.1
spi1-SCLK: Arduino_SPI.5, RP2040.13, TP_BMS_SCLK.1
spi-MISO: R13.2, TP_CAN_MISO.1, U3.12, U6.12
spi-MOSI: R14.2, TP_CAN_MOSI.1, U3.11, U6.11
spi-SCLK: R12.2, TP_CAN_SCLK.1, U3.10, U6.10
usb_vbus-VCC: D1.2, USB1.A4, USB1.A9, USB1.B4, USB1.B9
vout_sw-VCC: C13.1, C14.1, C15.1, L1.1, L2.2, R9.1
