BYU-Racing/bms_hardware/(commit log)

2026-07-02 first commit, including icd outline and kicad projects
    [bms_flex_pcb.kicad_pcb, bms_flex_pcb.kicad_sch, bms_master_pcb.kicad_pcb, bms_master_pcb.kicad_sch, bms_slave_pcb.kicad_pcb, bms_slave_pcb.kicad_sch]
2026-07-06 Completed first draft of BMS Master ICD.
2026-07-06 added connectors and circuit protection to BMS Master ICD.
2026-07-08 changes made during ICD meeting.
    [bms_master_pcb.kicad_sch]
2026-08-03 had to redo the master board after encountering an unfixable bug. bms_master_pcb2 is the one to keep working on.
    [MS_05-08-1669_ADI.step, bms_master_pcb.kicad_sch, bms_master_pcb2.kicad_pcb, bms_master_pcb2.kicad_sch, can.kicad_sch, digital_outputs.kicad_sch, isospi.kicad_sch, power.kicad_sch]
2026-08-11 Add files via upload
    almost done with the PCB layout. Harrison needs to fix routing on the differential pairs
    [bms_master_pcb2.kicad_pcb, bms_master_pcb2.kicad_sch, can.kicad_sch, digital_outputs.kicad_sch, isospi.kicad_sch, power.kicad_sch, usb.kicad_sch]
2026-08-11 Add files via upload
    Slave Boards Version 1.01 that are ready to be manufactured
    [bms_slave_pcb.kicad_pcb, bms_slave_pcb.kicad_sch, cell_stack.kicad_sch, isoSPI_daisy_chain.kicad_sch, power_rail.kicad_sch, temp_sensors.kicad_sch, voltage_taps.kicad_sch]
2026-08-12 added diff routing for usb
    [bms_master_pcb2.kicad_pcb]
2026-08-14 Add files via upload
    finished and ready to order V1.01
    [bms_master_pcb2.kicad_pcb, bms_master_pcb2.kicad_sch, can.kicad_sch, isospi.kicad_sch]
2026-08-19 First iteration sent to manufacture
    [bms_flex_pcb.kicad_pcb, bms_flex_pcb.kicad_sch]
2026-09-30 Added cell emulator board first version
    [bms_cell_emulator_board.kicad_pcb, bms_cell_emulator_board.kicad_sch, bms_slave_pcb.kicad_pcb, bms_slave_pcb.kicad_sch, cell_stack.kicad_sch, isoSPI_daisy_chain.kicad_sch, power_rail.kicad_sch, temp_sensors.kicad_sch]
2026-10-02 Fixed filenames in BMS Slave PCB V2.01, added equipment wishlist
    [bms_slave_pcb.kicad_pcb, bms_slave_pcb_V2.01.kicad_pcb, bms_slave_pcb_V2.01.kicad_sch, cell_stack.kicad_sch, isoSPI_daisy_chain.kicad_sch, power_rail.kicad_sch, temp_sensors.kicad_sch, voltage_taps.kicad_sch]
2026-11-10 Rugby's Final Changes
    Good Luck finishing the project! Hopefully you can find everything you need to finish this PCB in my notes
2026-11-10 Add README for BMS Control Unit V2 project
2026-11-10 Add README for BMS Flex PCB V1 documentation
    Added README.md to document the BMS Flex PCB V1 files and their intended use.
2026-11-10 Clarify voltage sense leads and FPC usage timeline
    Updated README to clarify terminology and timeline regarding FPCs.
2026-11-10 KiCad files for Isaac Rampton's junk
2026-11-10 Create Rugby Transfer Notes for PCB development
    Added detailed notes and TODOs for the Cell Monitor and Main Control PCBs, including testing recommendations and component suggestions.
2026-11-10 Add OG 2027 BMS Timeline documentation
    Documented timelines for Master & Slave PCB and FPC development.
2026-11-10 Fix formatting in OG 2027 BMS Timeline documentation
2026-11-10 Create README for 2027 BMS project documentation
    Added initial README with project overview.
2026-11-10 Update README with clearer leadership guidance
    Clarify the guidance for leadership inquiries regarding the BMS project.
2026-11-10 Update acronym 'BMS' to 'Battery Management System'
2026-11-10 Revise thermistor connectors and add new component options
    Updated connector suggestions for thermistors and added new options for thermistors and current sensors.
2026-11-10 Update Rugby Transfer Notes with new considerations
    Added considerations for temperature sensing, fuse block, and zener diodes in Rugby Transfer Notes.
2026-11-12 added mechanical adjustments to the voltage tap hole fitments in reference to pcb sizing
2026-11-12 fixed voltage taps and mounting point positioning
2026-11-12 added mounting holes and test points for module test bench board
2026-11-12 fixed voltage tap measurement
2026-11-13 Fixed footprint for switching regulator. Switched it from bms_slave_pcb:MSOP-16_MSE_LIT to Package_SO:MSOP-16-1EP_3x4.039mm_P0.5mm_EP1.651x2.845mm to make pins easier to solder.
2026-11-14 Changed back footprint per I was mistaken
2026-11-14 fixed voltage tap spacings
2026-11-14 added led driver and pushpull for bms dio
2026-11-14 fixed the frickin led driver
2026-11-14 added isolated CAN for current sense
2026-11-14 fixed buck power symbols
